ryood/Nucleo_DCO/chassis/Nucleo_DCO_Panel_Design.xlsx

Nucleo_DCO_Panel_Design
2018.11.27
 |  |  |  |  |  |  |  |  | Power LED
 | OSC1 Shape |  | OSC2 Shape |  | OSC3 Shape |  | Master Level
 | OSC1 Detune |  | OSC2 Detune |  | OSC3 Detune |  | Frequency
 | OSC1 Range |  | OSC2 Range |  | OSC3 Range
 |  | LED |  | LED |  | LED | Display | Displya
 | OSC1 PW Valid |  | OSC2 PW Valid |  | OSC3 PW Valid |  | Mode SW | Off SW
 |  |  |  |  |  |  | ADC Off | Reserved
 |  |  |  |  |  |  | SW | SW
 | OSC1 PW |  | OSC2 PW |  | OSC3 PW
 |  |  |  |  |  |  |  |  | LED
 |  |  |  |  |  |  |  |  | Level Clip
 | OSC1 Level |  | OSC2 Level |  | OSC3 Level |  | Digital Level
