ryood/Nucleo_DCO/chassis/Nucleo_DCO_Panel_Design.png

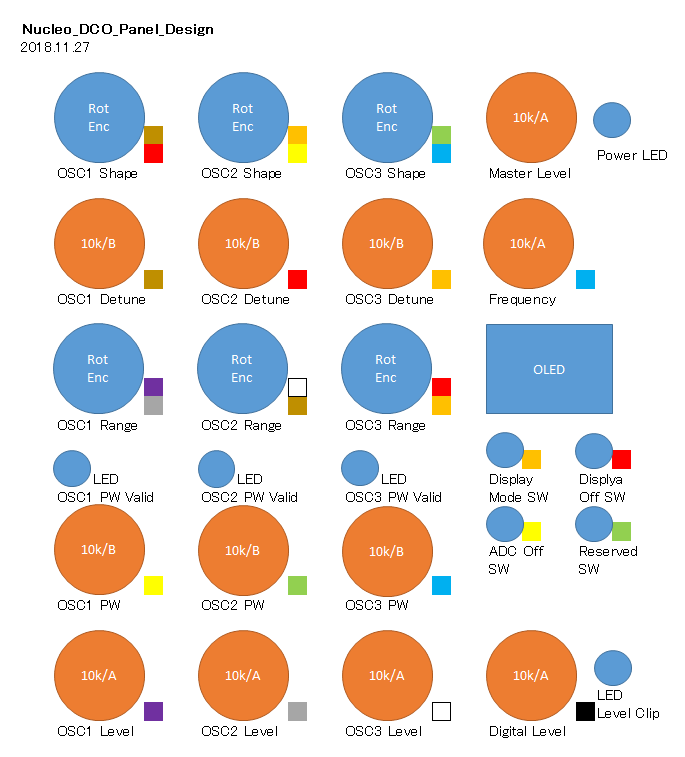
chassis/Nucleo_DCO_Panel_Design.png
