ryood/Nucleo_DCO/chassis/Test/Nucleo_DCO_Panel_Design.png

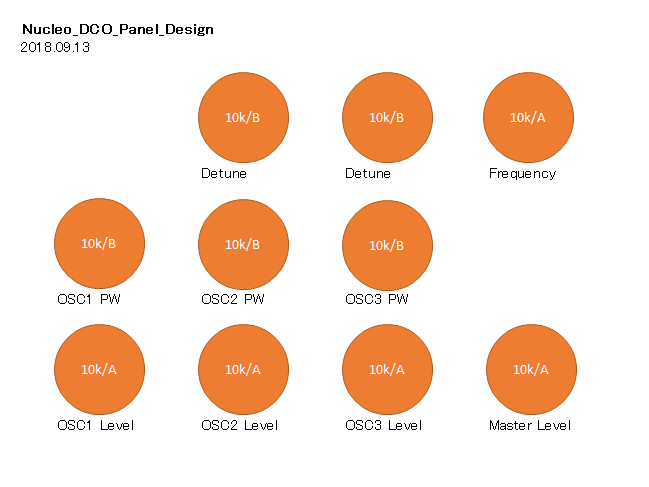
chassis/Test/Nucleo_DCO_Panel_Design.png
