ryood/Nucleo_DCO/fritzing/Nucleo_DCO_PSU_ブレッドボード.png

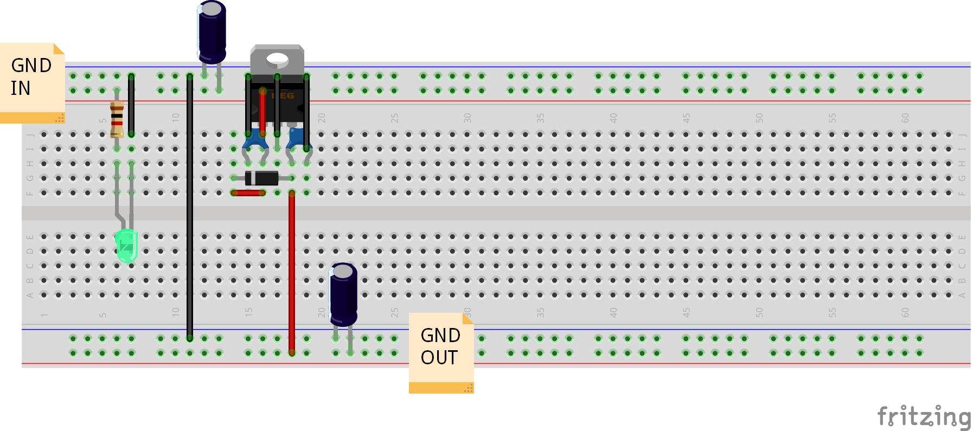
fritzing/Nucleo_DCO_PSU_ブレッドボード.png
