ryood/Nucleo_DCO/Nucleo_DCO ブロック図.png

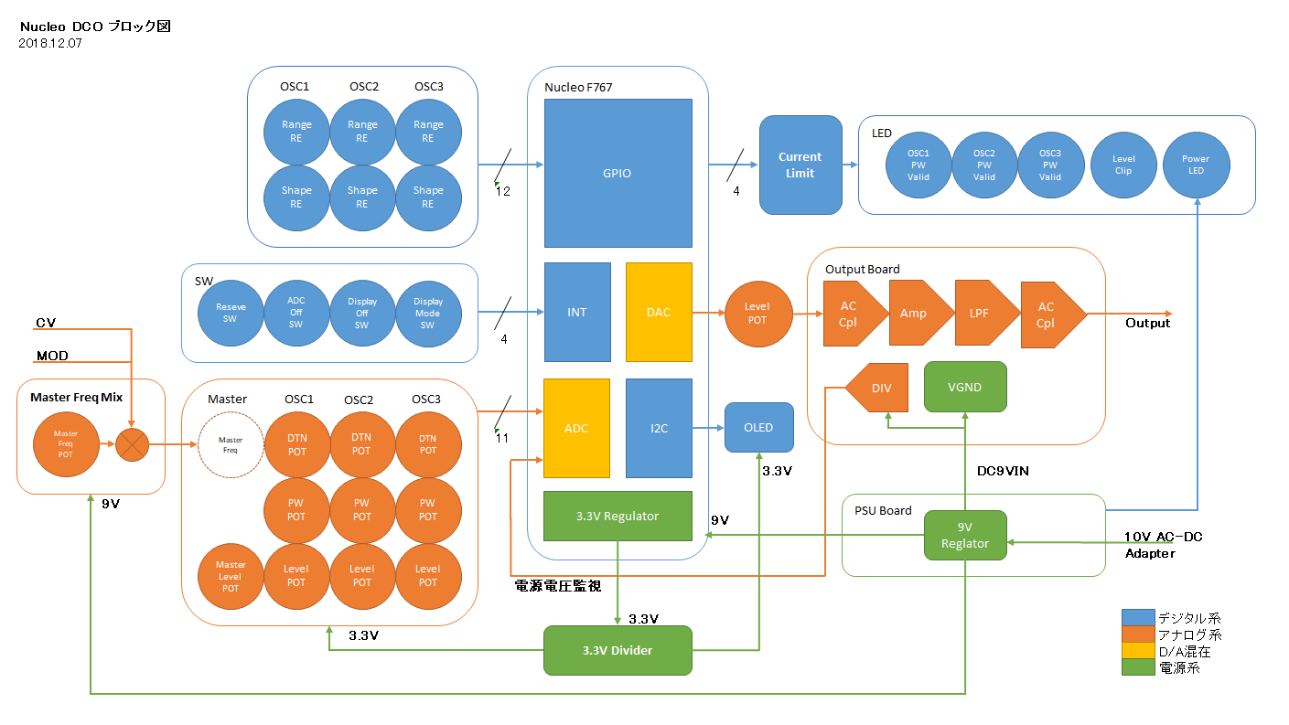
Nucleo_DCO ブロック図.png
