ryood/Nucleo_DCO/Nucleo_DCO ブロック図_Arduino_OLED.png

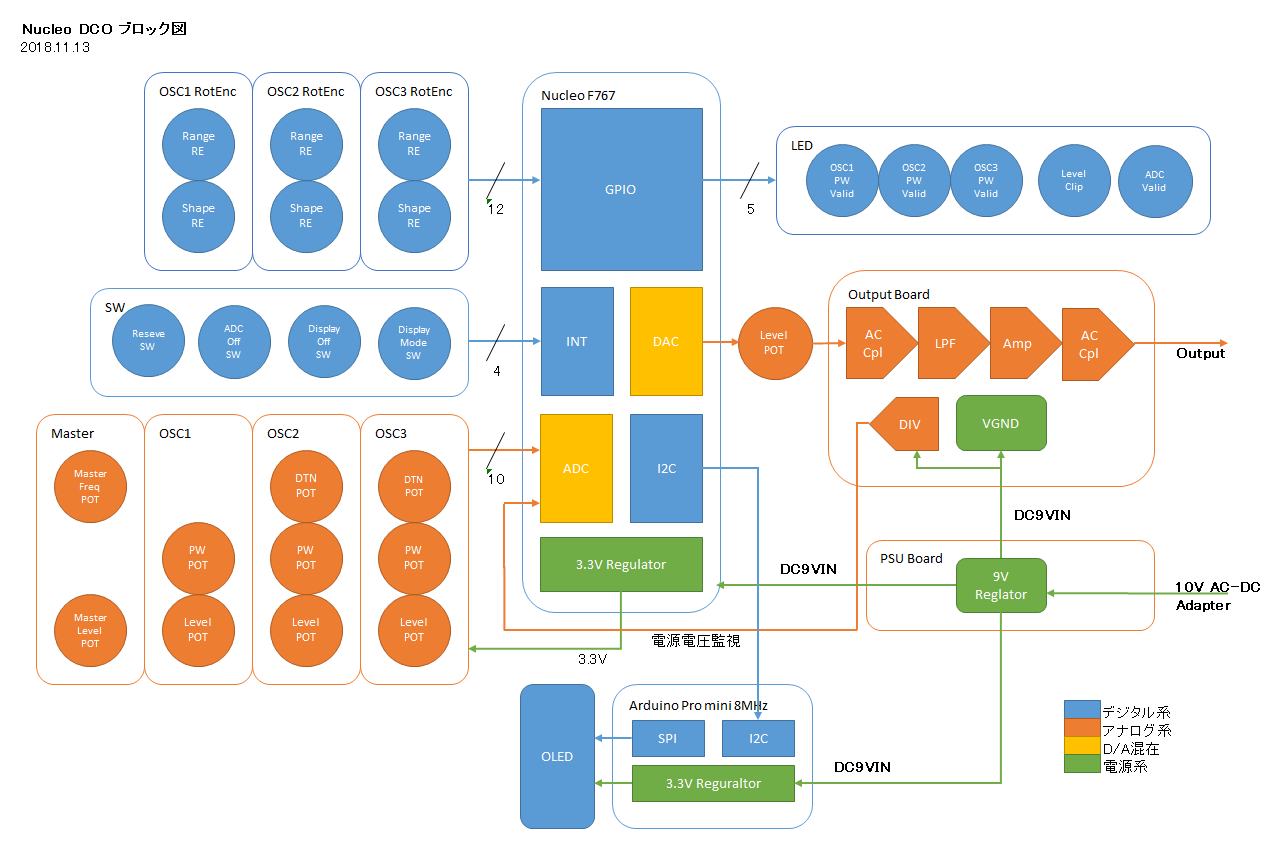
Nucleo_DCO ブロック図_Arduino_OLED.png
