ryood/Nucleo_DCO/Nucleo_DCO 出音テスト/Arduino EG テスト ブロック図.jpg

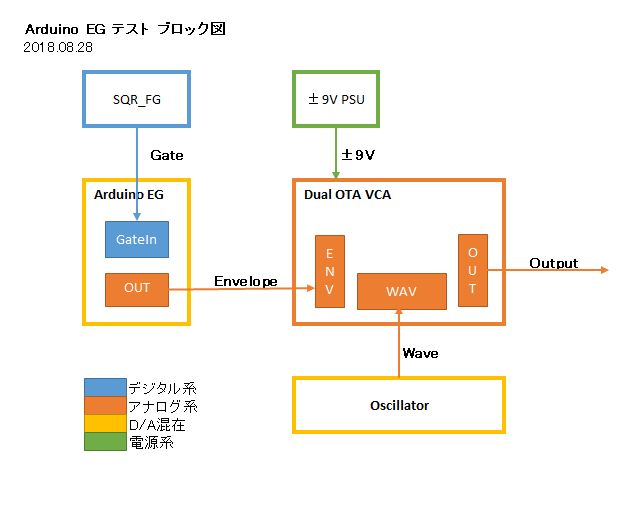
Nucleo_DCO 出音テスト/Arduino EG テスト ブロック図.jpg
