ryood/Nucleo_DCO/Nucleo_DCO 出音テスト/Nucleo_DCO + TLF 01(AntiLogMM) +Dual_OTA_VCA　＋Arduino_EG テストブロック図.png

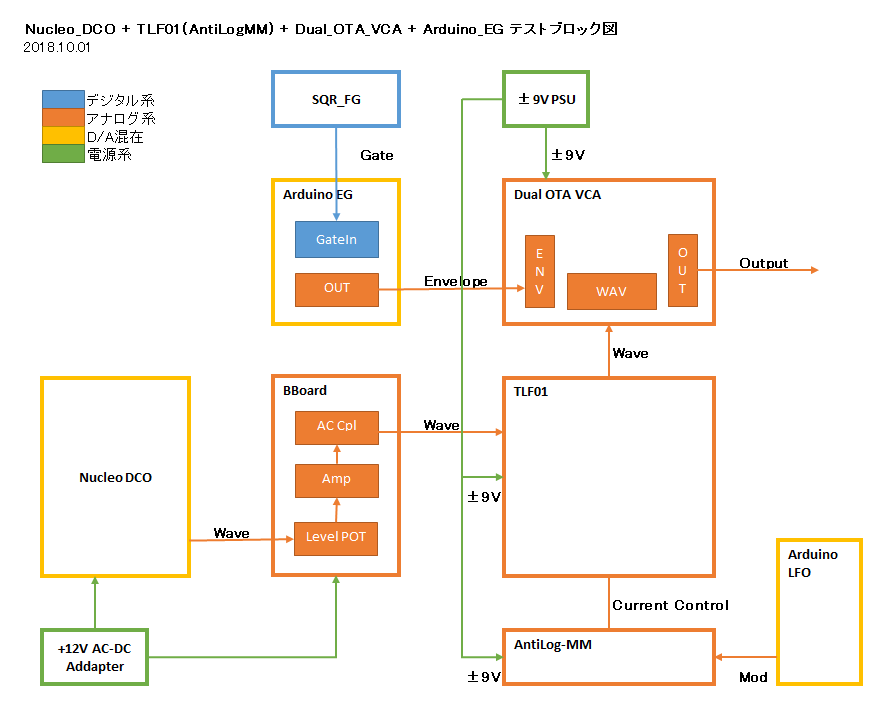
Nucleo_DCO 出音テスト/Nucleo_DCO + TLF 01(AntiLogMM) +Dual_OTA_VCA ＋Arduino_EG テストブロック図.png
