ryood/Nucleo_DCO/Nucleo_DCO 出音テスト/Nucleo_DCO ＋Dual_OTA_VCA + Arduino_LFO テスト ブロック図_V2.png

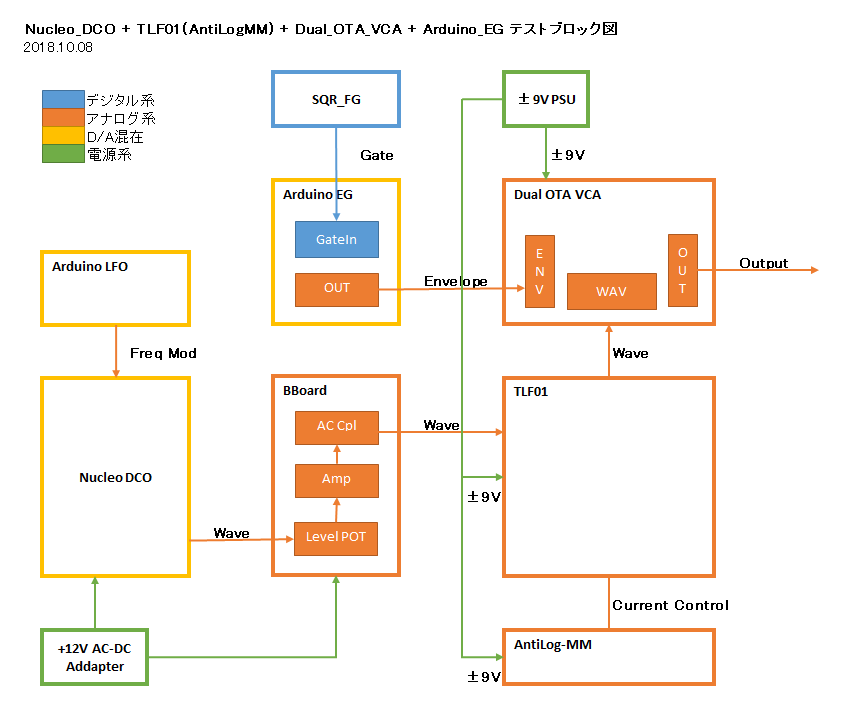
Nucleo_DCO 出音テスト/Nucleo_DCO ＋Dual_OTA_VCA + Arduino_LFO テスト ブロック図_V2.png
