ryood/Nucleo_DCO/Nucleo_DCO_Output_Board/eagle/Nucleo_DCO_Output_brd.png

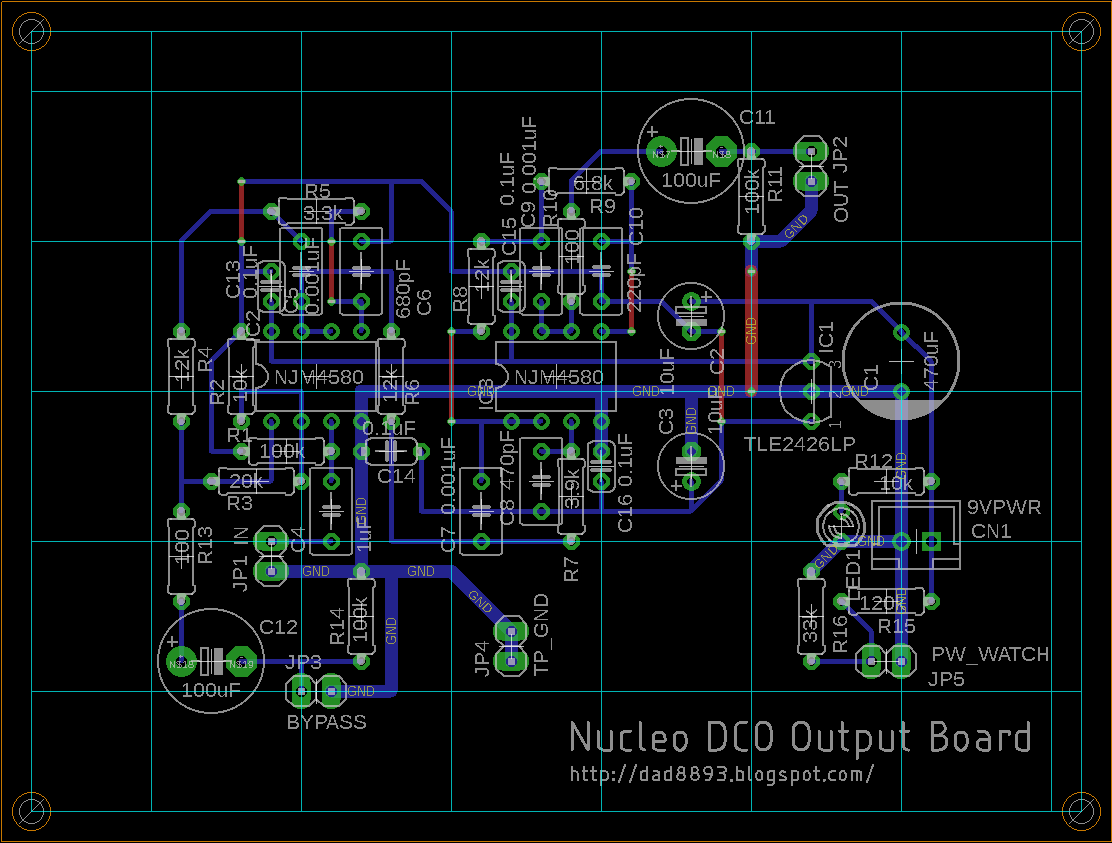
Nucleo_DCO_Output_Board/eagle/Nucleo_DCO_Output_brd.png
