ryood/Nucleo_DCO/Nucleo_DCO_Output_Board/eagle/Nucleo_DCO_Output_sch.png

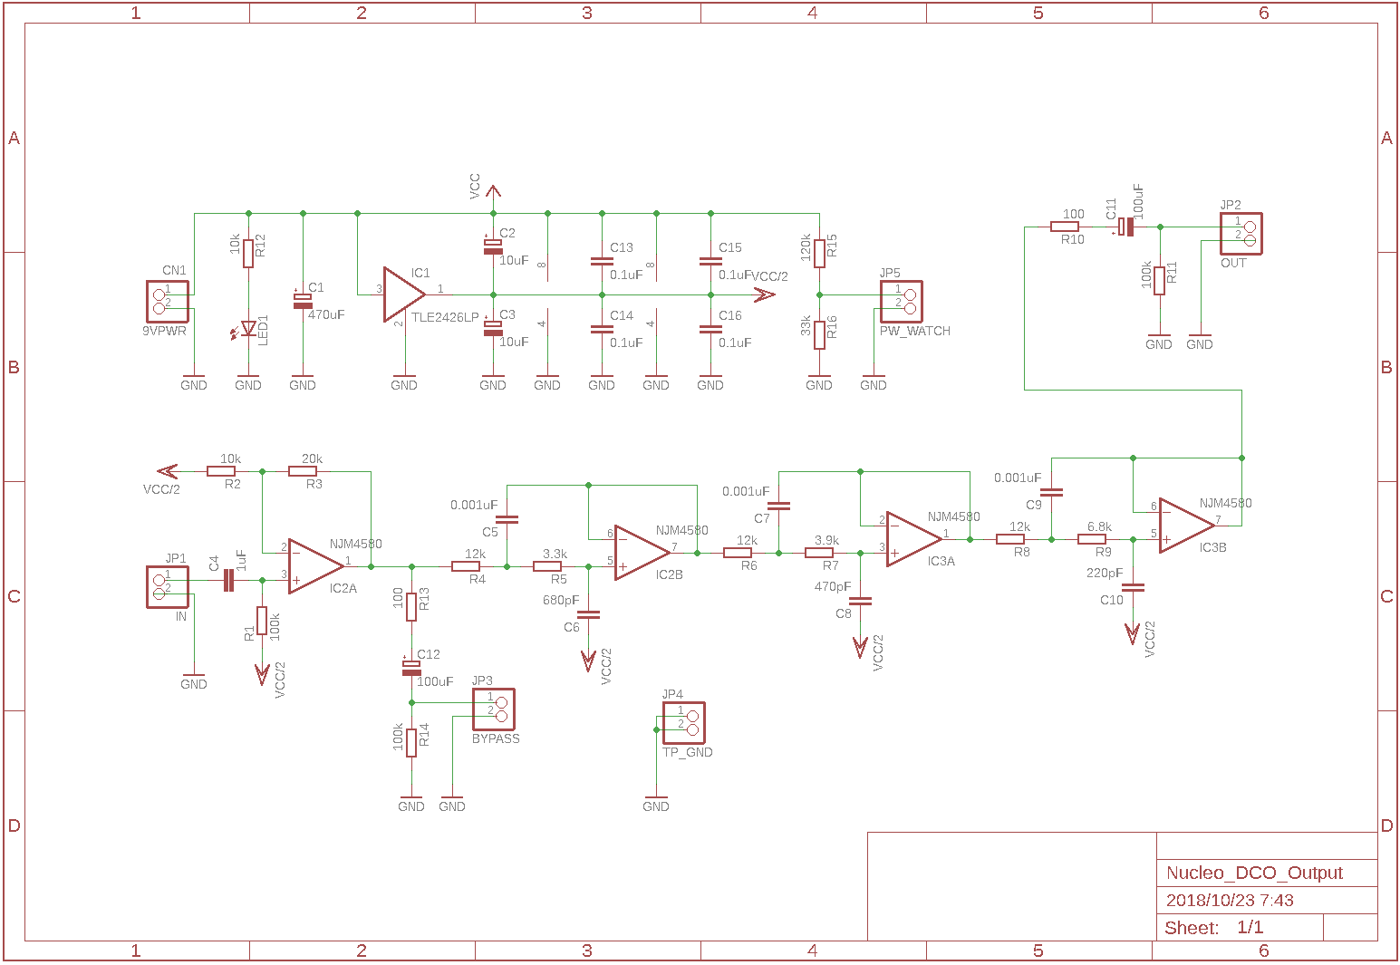
Nucleo_DCO_Output_Board/eagle/Nucleo_DCO_Output_sch.png
