ryood/Nucleo_DCO/Nucleo_DCO_Output_Board/fritzing/Nucleo_DCO_Output_VCVS_6th_Bessel _VGND+DCO_ブレッドボード.png

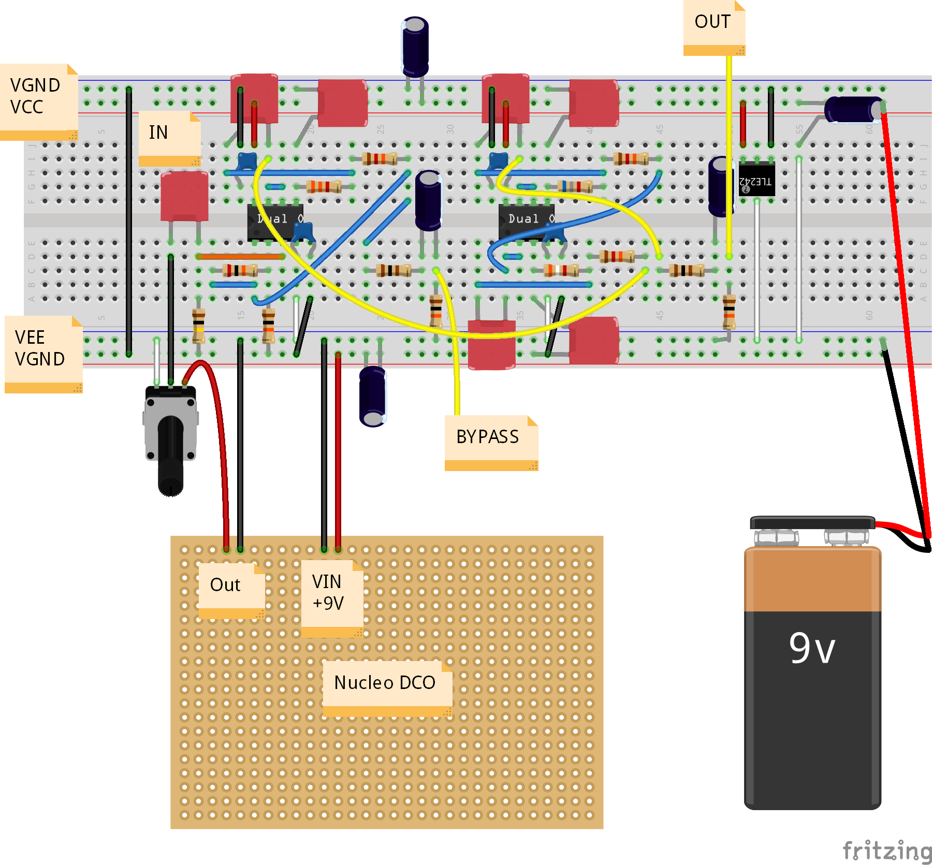
Nucleo_DCO_Output_Board/fritzing/Nucleo_DCO_Output_VCVS_6th_Bessel _VGND+DCO_ブレッドボード.png
