ryood/Nucleo_DCO/Nucleo_DCO_Output_Board/Nucleo_DCO_Output_Board_FChara.png

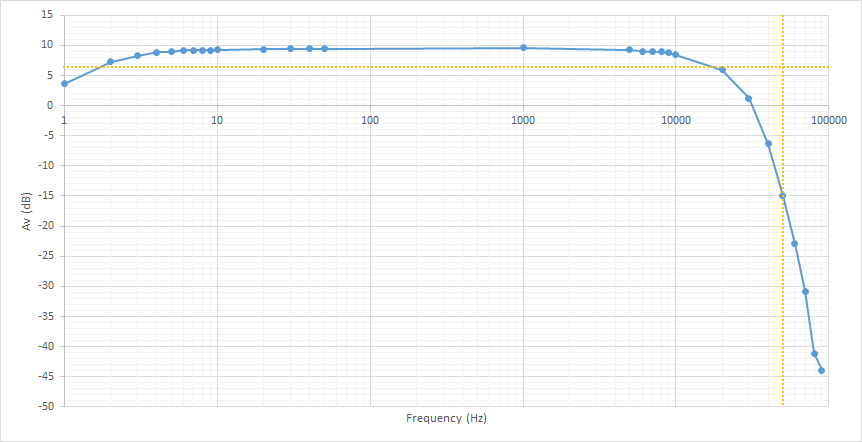
Nucleo_DCO_Output_Board/Nucleo_DCO_Output_Board_FChara.png
