ryood/Nucleo_DCO/Nucleo_DCO_Output_Board/Nucleo_DCO_出力部_ブロック図.png

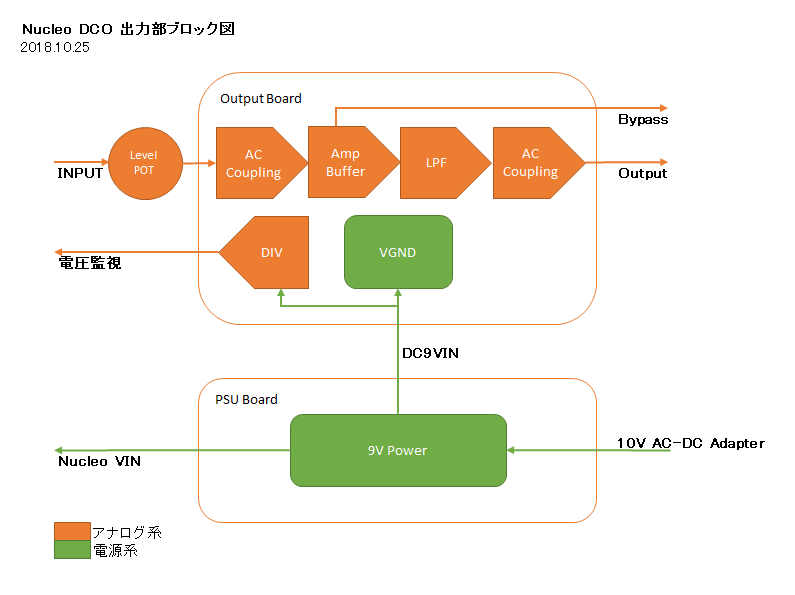
Nucleo_DCO_Output_Board/Nucleo_DCO_出力部_ブロック図.png
