ryood/Nucleo_DCO/Nucleo_DCO接続一覧表.png

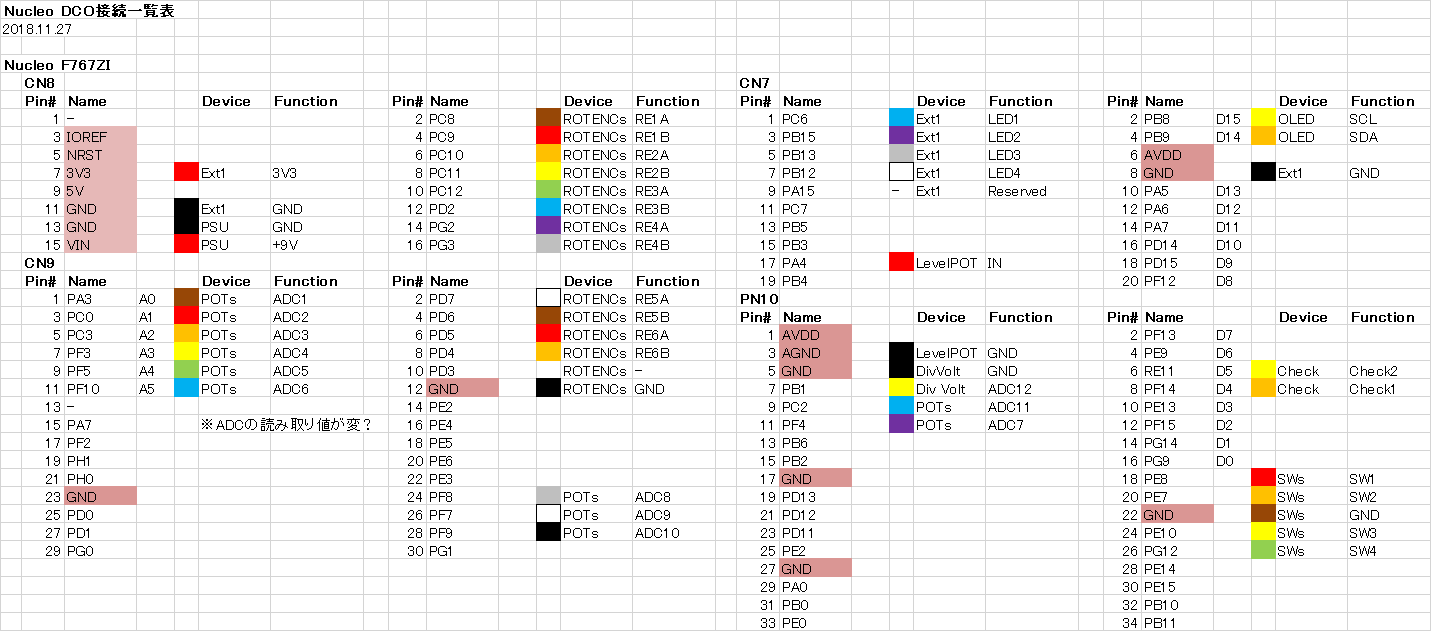
Nucleo_DCO接続一覧表.png
