ryood/Nucleo_DCO/mbed/Nucleo_DCO_Test04/Nucleo_DCO_Test04 ピンアサイン.xlsx

Nucleo_DCO_Test04 ピンアサイン
2018.08.30
Arduino | Nucleo | Description
D15 | PB_8 | OLED/I2C/SCL
D14 | PB_9 | OLED/I2C/SDA
GND | GND | OLED/GND
D5 | PE_11 | CheckPin
D4 | PF_14 | CheckPin
- | PA_4 | WaveOut
