ryood/Nucleo_DCO/Nucleo_DCO表示データ・I2C通信・フォーマット.xlsx

Nucleo_DCO表示データ・I2C通信・フォーマット
2018.11.03
I2C Clock(Hz) | 100000
Mode | Mode# | Name | 型 | Size(Byte) | 説明 | 通信バイト数 | 通信時間(us)
DM_TITLE | 0 | TitleStr1 | - | 0 | Mode#128以降の文字列を表示 | 0 | 160
DM_NORMAL | 1 | WaveShape1 | uint_8 | 1 | OSC1の波形番号
DM_NORMAL | 1 | WaveShape2 | uint_8 | 1 | OSC2の波形番号
DM_NORMAL | 1 | WaveShape3 | uint_8 | 1 | OSC3の波形番号
DM_NORMAL | 1 | FreqRange1 | uint_8 | 1 | OSC1の周波数レンジ番号
DM_NORMAL | 1 | FreqRange2 | uint_8 | 1 | OSC2の周波数レンジ番号
DM_NORMAL | 1 | FreqRange3 | uint_8 | 1 | OSC3の周波数レンジ番号
DM_NORMAL | 1 | FPS | uint_16 | 2 | フレームレート（0.1Hz単位）
DM_NORMAL | 1 | BattVoltage | uint_8 | 1 | 電源電圧（0.1V単位）
DM_NORMAL | 1 | ADCAvailable | uint_8 | 1 | ADC読み取り有効:1 無効:2 | 10 | 960
DM_FREQUENCY | 2 | Rate1 | uint_16 | 2 | OSC1の周波数(0.1Hz単位)
DM_FREQUENCY | 2 | Rate2 | uint_16 | 2 | OSC2の周波数(0.1Hz単位)
DM_FREQUENCY | 2 | Rate3 | uint_16 | 2 | OSC3の周波数(0.1Hz単位)
DM_FREQUENCY | 2 | Detune1 | int_16 | 2 | OSC1のデチューン(0.001Hz単位)
DM_FREQUENCY | 2 | Detune2 | int_16 | 2 | OSC2のデチューン(0.001Hz単位)
DM_FREQUENCY | 2 | Detune3 | int_16 | 2 | OSC3のデチューン(0.001Hz単位) | 12 | 1120
DM_AMPLITUDE | 3 | Amplitude1 | int16 | 2 | OSC1のボリューム(0.001単位）
DM_AMPLITUDE | 3 | Amplitude2 | int16 | 2 | OSC2のボリューム(0.001単位）
DM_AMPLITUDE | 3 | Amplitude3 | int16 | 2 | OSC3のボリューム(0.001単位）
DM_AMPLITUDE | 3 | MasterAmplitude | int16 | 2 | マスターボリューム(0.001単位）
DM_AMPLITUDE | 3 | Clip | uint8_t | 1 | クリップ 有:1 無:0 | 9 | 880
DM_PULSE_WIDTH | 4 | PulseWidth1 | int16 | 2 | OSC1のパルスワイズ(0.001単位)
DM_PULSE_WIDTH | 4 | PulseWidth2 | int16 | 2 | OSC1のパルスワイズ(0.001単位)
DM_PULSE_WIDTH | 4 | PulseWidth3 | int16 | 2 | OSC1のパルスワイズ(0.001単位) | 6 | 640
TITLE_STR1 | 128 | TitleStr1 | 固定長文字列 | 32 | プログラム名
TITLE_STR2 | 129 | TitleStr2 | 固定長文字列 | 32 | 日付
TITLE_STR3 | 130 | TitleStr3 | 固定長文字列 | 32 | 時刻 | 96 | 7840
DM_DISPLAY_OFF | 255 | DisplayMessage | uint8_t | 1 | メッセージの表示:1 非表示:0 | 1 | 240
