ryood/Nucleo_DCO/Nucleo_DCO_Output_Board/Nucleo DCO LPF 設計.xlsx

Nucleo DCO LPF 設計
2018.10.04
MFB 4次バターワース特性
fc | 25000 | Hz
ステージ | F0 | fc | Q
1st | 1 | 25000 | 0.5412
2nd | 1 | 25000 | 1.3065
1st |  |  |  | ステージ | R1(kΩ) | R2(kΩ) | R3(kΩ) | C1(uF) | C2(pF)
R1 | 3.9 | kΩ |  | 1st | 3.9 | 10 | 3.9 | 0.0022 | 470
R2 | 10 | kΩ |  | 2nd | 4.7 | 8.2 | 4.7 | 0.0047 | 220
R3 | 3.9 | kΩ
C1 | 0.0022 | uF
C2 | 470 | pF
2nd
R1 | 4.7 | kΩ
R2 | 8.2 | kΩ
R3 | 4.7 | kΩ
C1 | 0.0047 | uF
C2 | 220 | pF
MFB 4次ベッセル特性
fc | 25000 | Hz
ステージ | F0 | fc | Q
1st | 1.4192 | 35480 | 0.5219
2nd | 1.5912 | 39780 | 0.8055
1st |  |  |  | ステージ | R1(kΩ) | R2(kΩ) | R3(kΩ) | C1(uF) | C2(pF)
R1 | 3.9 | kΩ |  | 1st | 3.9 | 12 | 3.9 | 0.0015 | 330
R2 | 12 | kΩ |  | 2nd | 3.3 | 8.2 | 3.3 | 0.0022 | 220
R3 | 3.9 | kΩ
C1 | 0.0015 | uF
C2 | 330 | pF
2nd
R1 | 3.3 | kΩ
R2 | 8.2 | kΩ
R3 | 3.3 | kΩ
C1 | 0.0022 | uF
C2 | 220 | pF
MFB 4次ベッセル特性
fc | 20000 | Hz
ステージ | F0 | fc | Q
1st | 1.4192 | 28384 | 0.5219
2nd | 1.5912 | 31824 | 0.8055
1st |  |  |  | ステージ | R1(kΩ) | R2(kΩ) | R3(kΩ) | C1(uF) | C2(pF)
R1 | 4.7 | kΩ |  | 1st | 4.7 | 8.2 | 4.7 | 0.0015 | 470
R2 | 8.2 | kΩ |  | 2nd | 4.7 | 12 | 4.7 | 0.0022 | 220
R3 | 4.7 | kΩ
C1 | 0.0015 | uF
C2 | 470 | pF
2nd
R1 | 4.7 | kΩ
R2 | 12 | kΩ
R3 | 4.7 | kΩ
C1 | 0.0022 | uF
C2 | 220 | pF
MFB 8次ベッセル特性
fc | 25000 | Hz
ステージ | F0 | fc | Q
1st | 1.7838 | 44595 | 0.506
2nd | 2.1953 | 54882.5 | 1.2258
3rd | 1.9591 | 48977.5 | 0.7109
4th | 1.8378 | 45945 | 0.5597
1st |  |  |  | ステージ | R1(kΩ) | R2(kΩ) | R3(kΩ) | C1(uF) | C2(pF)
R1 | 3.9 | kΩ |  | 1st | 3.9 | 15 | 3.9 | 0.001 | 220
R2 | 15 | kΩ |  | 2nd | 3.9 | 15 | 3.9 | 0.0022 | 68
R3 | 3.9 | kΩ |  | 3rd | 3.3 | 15 | 3.3 | 0.0015 | 150
C1 | 0.001 | uF |  | 4th | 4.7 | 12 | 4.7 | 0.001 | 220
C2 | 220 | pF
2nd
R1 | 3.9 | kΩ
R2 | 15 | kΩ
R3 | 3.9 | kΩ
C1 | 0.0022 | uF
C2 | 68 | pF
3rd
R1 | 3.3 | kΩ
R2 | 15 | kΩ
R3 | 3.3 | kΩ
C1 | 0.0015 | uF
C2 | 150 | pF
4th
R1 | 4.7 | kΩ
R2 | 12 | kΩ
R3 | 4.7 | kΩ
C1 | 0.001 | uF
C2 | 220 | pF
MFB 8次ベッセル特性
fc | 20000 | Hz
ステージ | F0 | fc | Q
1st | 1.7838 | 35676 | 0.506
2nd | 2.1953 | 43906 | 1.2258
3rd | 1.9591 | 39182 | 0.7109
4th | 1.8378 | 36756 | 0.5597
1st |  |  |  | ステージ | R1(kΩ) | R2(kΩ) | R3(kΩ) | C1(uF) | C2(pF)
R1 | 3.3 | kΩ |  | 1st | 3.3 | 12 | 3.3 | 0.0015 | 330
R2 | 12 | kΩ |  | 2nd | 4.7 | 12 | 4.7 | 0.0022 | 100
R3 | 3.3 | kΩ |  | 3rd | 4.7 | 10 | 4.7 | 0.0015 | 220
C1 | 0.0015 | uF |  | 4th | 3.9 | 8.2 | 3.9 | 0.0015 | 330
C2 | 330 | pF
2nd
R1 | 4.7 | kΩ
R2 | 12 | kΩ
R3 | 4.7 | kΩ
C1 | 0.0022 | uF
C2 | 100 | pF
3rd
R1 | 4.7 | kΩ
R2 | 10 | kΩ
R3 | 4.7 | kΩ
C1 | 0.0015 | uF
C2 | 220 | pF
4th
R1 | 3.9 | kΩ
R2 | 8.2 | kΩ
R3 | 3.9 | kΩ
C1 | 0.0015 | uF
C2 | 330 | pF
MFB 6次ベッセル特性
fc | 20000 | Hz
ステージ | F0 | fc | Q
1st | 1.606 | 32120 | 0.5103
2nd | 1.6913 | 33826 | 0.6112
3rd | 1.9071 | 38142 | 1.0234
1st |  |  |  | ステージ | R1(kΩ) | R2(kΩ) | R3(kΩ) | C1(uF) | C2(pF)
R1 | 3.9 | kΩ |  | 1st | 3.9 | 1.2 | 3.9 | 0.0015 | 330
R2 | 12 | kΩ |  | 2nd | 4.7 | 8.2 | 4.7 | 0.0015 | 330
R3 | 3.9 | kΩ |  | 3rd | 4.7 | 12 | 4.7 | 0.0022 | 150
C1 | 0.0015 | uF
C2 | 330 | pF
2nd
R1 | 4.7 | kΩ
R2 | 8.2 | kΩ
R3 | 4.7 | kΩ
C1 | 0.0015 | uF
C2 | 330 | pF
3rd
R1 | 4.7 | kΩ
R2 | 12 | kΩ
R3 | 4.7 | kΩ
C1 | 0.0022 | uF
C2 | 150 | pF
VCVS 6次ベッセル特性
fc | 20000 | Hz
ステージ | F0 | fc | Q
1st | 1.606 | 32120 | 0.5103
2nd | 1.6913 | 33826 | 0.6112
3rd | 1.9071 | 38142 | 1.0234
1st |  |  |  | ステージ | R1(kΩ) | R2(kΩ) | C1(uF) | C2(pF)
R1 | 12 | kΩ |  | 1st | 12 | 3.3 | 0.001 | 680
R2 | 3.3 | kΩ |  | 2nd | 12 | 3.9 | 0.001 | 470
C1 | 0.001 | uF |  | 3rd | 12 | 6.8 | 0.001 | 220
C2 | 680 | pF
2nd
R1 | 12 | kΩ
R2 | 3.9 | kΩ
C1 | 0.001 | uF
C2 | 470 | pF
3rd
R1 | 12 | kΩ
R2 | 6.8 | kΩ
C1 | 0.001 | uF
C2 | 220 | pF
