ryood/Nucleo_DCO/(list of files, cad)

Other CAD files:
chassis/Nucleo_DCO_Top_Panel.dwg
chassis/Test/NucleoDCO_RotEnc_Panel(Test).dwg
chassis/Nucleo_DCO_Bottom_Panel.dwg
chassis/Test/NucleoDCO_POT_Panel(Test).dwg
