ryood/Nucleo_DCO/doc/Floating Point Test Result 20180915.txt

===============================
Mbed OS 5

Floating Point Test
Sep 15 2018 20:30:57

LOOP_N: 100000

float
op      total   1-op(us)
-------------------------------
addf    3708    0.037080
subf    7417    0.074170
mulf    11125   0.111250
divf    21784   0.217840
sinf    55664   0.556640
cosf    59404   0.594040
expf    76539   0.765390
logf    82766   0.827660
sqrtf   131143  1.311430
powf32  228002  2.280020
tword_f 218120  2.181200

double
op      total   1-op(us)
-------------------------------
add     223522  2.235220
sub     229228  2.292280
mul     236179  2.361790
div     254717  2.547170
sin     88683   0.886830
cos     95088   0.950880
exp     116889  1.168890
log     127590  1.275900
sqrt    323866  3.238660
pow32   60690   0.606900
tword   21782   0.217820

End.

===============================
Mbed 2

Floating Point Test
Sep 15 2018 11:33:49

LOOP_N: 100000

float
op      total   1-op(us)
-------------------------------
addf    2549    0.025490
subf    4866    0.048660
mulf    7416    0.074160
divf    16682   0.166820
sinf    37082   0.370820
cosf    35549   0.355490
expf    53734   0.537340
logf    48837   0.488370
sqrtf   22935   0.229350
powf32  159155  1.591550
tword_f 160074  1.600740

double
op      total   1-op(us)
-------------------------------
add     164085  1.640850
sub     168400  1.684000
mul     173960  1.739600
div     190871  1.908710
sin     93309   0.933090
cos     111853  1.118530
exp     104258  1.042580
log     136975  1.369750
sqrt    37065   0.370650
pow32   392082  3.920820
tword   348061  3.480610

End.
