ryood/Nucleo_DCO/doc/InterpolateFloat Result.txt

0.172,  0.456,  0.176,  0.457,  0.512,  0.174,  0.515,  0.467,  0.165,  0.164,
0.172,  0.456,  0.176,  0.457,  0.512,  0.174,  0.516,  0.466,  0.165,  0.164,
0.172,  0.456,  0.176,  0.457,  0.512,  0.174,  0.515,  0.466,  0.165,  0.163,
0.172,  0.457,  0.176,  0.457,  0.512,  0.173,  0.516,  0.466,  0.165,  0.163,
0.172,  0.456,  0.176,  0.457,  0.512,  0.172,  0.515,  0.466,  0.165,  0.163,
0.173,  0.456,  0.176,  0.457,  0.512,  0.173,  0.515,  0.466,  0.165,  0.163,
0.173,  0.456,  0.176,  0.457,  0.512,  0.173,  0.516,  0.466,  0.165,  0.164,
0.173,  0.456,  0.176,  0.457,  0.512,  0.173,  0.516,  0.466,  0.165,  0.164,
0.172,  0.456,  0.176,  0.457,  0.512,  0.173,  0.515,  0.466,  0.165,  0.164,
0.173,  0.456,  0.176,  0.457,  0.512,  0.173,  0.515,  0.467,  0.165,  0.164,
0.173,  0.456,  0.176,  0.457,  0.512,  0.174,  0.515,  0.466,  0.165,  0.163,
0.173,  0.456,  0.176,  0.457,  0.512,  0.173,  0.515,  0.467,  0.165,  0.164,
0.173,  0.456,  0.176,  0.457,  0.512,  0.173,  0.515,  0.467,  0.165,  0.164,
0.173,  0.456,  0.176,  0.457,  0.512,  0.172,  0.515,  0.467,  0.165,  0.164,
0.173,  0.456,  0.176,  0.457,  0.512,  0.172,  0.516,  0.467,  0.165,  0.164,
0.173,  0.456,  0.176,  0.457,  0.512,  0.171,  0.515,  0.467,  0.165,  0.164,
0.172,  0.456,  0.176,  0.457,  0.512,  0.172,  0.516,  0.467,  0.165,  0.163,
0.172,  0.456,  0.176,  0.457,  0.512,  0.172,  0.515,  0.467,  0.165,  0.163,
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
0.171,  0.452,  0.175,  0.453,  0.507,  0.172,  0.510,  0.463,  0.163,  0.162,
0.171,  0.452,  0.175,  0.453,  0.508,  0.173,  0.510,  0.463,  0.164,  0.162,
0.171,  0.453,  0.175,  0.453,  0.508,  0.173,  0.511,  0.464,  0.164,  0.162,
0.171,  0.453,  0.176,  0.454,  0.509,  0.173,  0.513,  0.464,  0.164,  0.163,
0.172,  0.454,  0.175,  0.454,  0.510,  0.173,  0.514,  0.465,  0.164,  0.163,
0.172,  0.454,  0.176,  0.454,  0.510,  0.172,  0.513,  0.465,  0.164,  0.163,
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
