ryood/Nucleo_DCO/fritzing/ADC_VREF_Test01_ブレッドボード.png

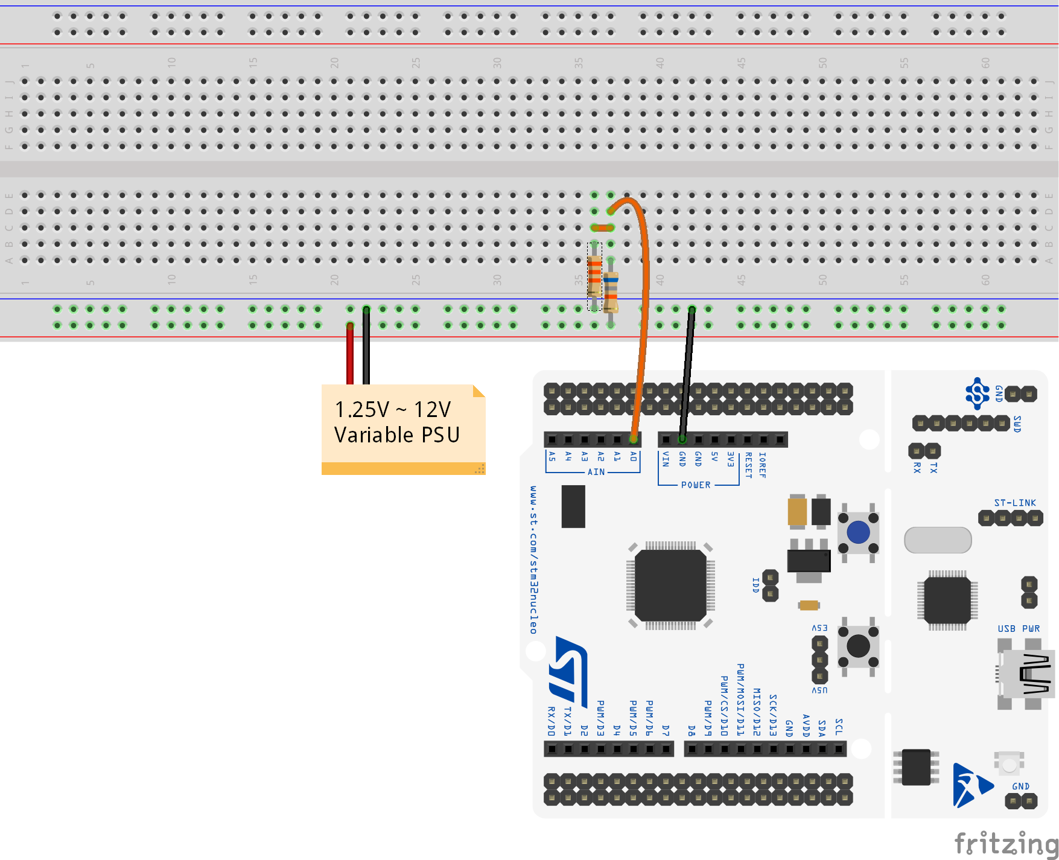
fritzing/ADC_VREF_Test01_ブレッドボード.png
