ryood/Nucleo_DCO/fritzing/Nucleo_DCO_Test20_Single_Supply_OutputBoard_ブレッドボード.png

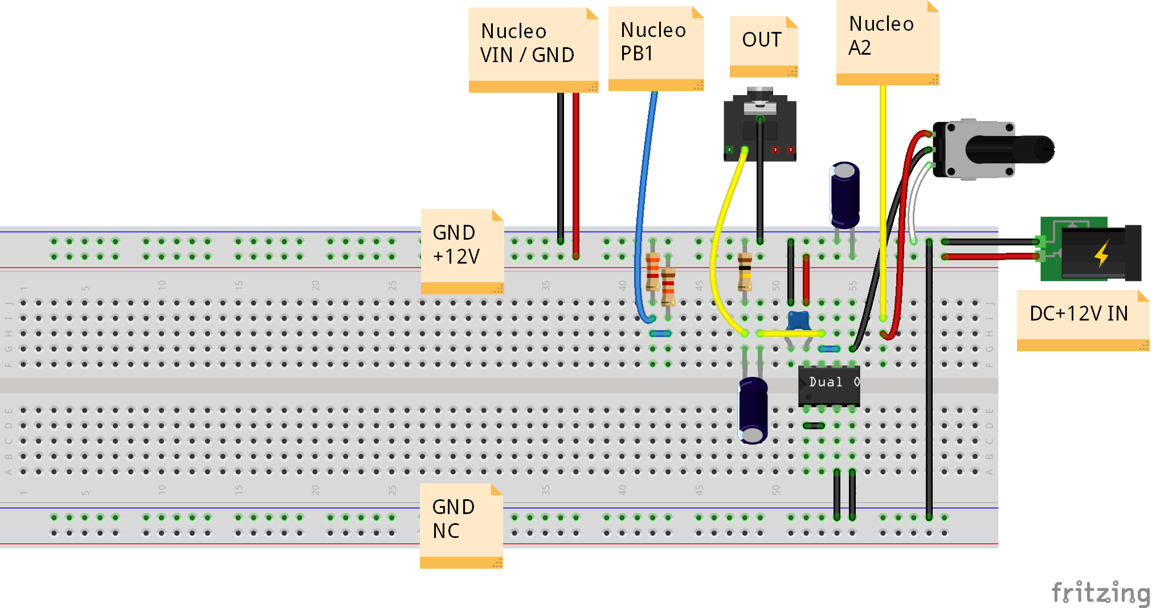
fritzing/Nucleo_DCO_Test20_Single_Supply_OutputBoard_ブレッドボード.png
