ryood/Nucleo_DCO/spice/Nucleo_DCO_Mix.asc

R1: res; 1k
R2: res; 1k
U1: UniversalOpamp2
V1: voltage; SINE(0.5 0.5 1k)
V2: voltage; SINE(0.5 0.5 2k 0 0 {Phase})
V3: voltage; 9
Named nets: 0, VCC, OUT
.tran 3m
.step param phase list 0 180
