ryood/Nucleo_DCO/Nucleo_DCO_Output_Board/spice/Nucleo_DCO_Output_VCVS_6th_Bessel_SQR_2.asc

C1: cap; 0.001u
C2: cap; 680p
C3: cap; 0.001u
C4: cap; 470p
C5: cap; 0.001u
C6: cap; 220p
C7: cap; 1u
C8: cap; 100u
C9: cap; 100u
R1: res; 12k
R2: res; 3.3k
R3: res; 12k
R4: res; 3.9k
R5: res; 12k
R6: res; 6.8k
R7: res; 10k
R8: res; 20k
R9: res; 2.5k
R10: res; 7.5k
R11: res; 100k
R12: res; 10k
R13: res; 10k
R14: res; 100
R15: res; 100
U1: UniversalOpamp2
U2: UniversalOpamp2
U3: UniversalOpamp2
U4: UniversalOpamp2
V1: voltage; PULSE(0 3 0 1f 1f 25u 50u); AC 1
V2: voltage; 4.5
V3: voltage; 4.5
Named nets: VCC, IN, OUT, 0, BYPASS, VEE, VCC/2, V1
.tran 0 1 999.85m
;ac oct 40 1 100k
10k/A POT
