ryood/Nucleo_DCO/Nucleo_DCO_Output_Board/spice/Nucleo_DCO_LFO_MFB_4th.asc

C1: cap; ""
C2: cap; ""
C3: cap; ""
C4: cap; ""
R1: res; ""
R2: res; ""
R3: res; ""
R4: res; ""
R5: res; ""
R6: res; ""
U1: UniversalOpamp2
U2: UniversalOpamp2
V1: voltage; ""; AC 1
V2: voltage; 4.5
V3: voltage; -4.5
Named nets: 0, VCC, VEE, OUT, IN
.tran 0 100m 97m
;ac oct 20 1k 100k
