ryood/Nucleo_DCO/Nucleo_DCO_Output_Board/spice/Nucleo_DCO_LFO_MFB_4th_BW_25kHzz@10kHzSaw.asc

C1: cap; 0.0022u
C2: cap; 470p
C3: cap; 0.0047u
C4: cap; 220p
R1: res; 3.9k
R2: res; 10k
R3: res; 3.9k
R4: res; 4.7k
R5: res; 8.2k
R6: res; 4.7k
U1: UniversalOpamp2
U2: UniversalOpamp2
V1: voltage; PULSE(-1 1 0 0.1m 0 0 0.1m); AC 1
V2: voltage; 4.5
V3: voltage; -4.5
Named nets: 0, VCC, VEE, OUT, IN
;tran 0 10m 9.7m
.ac oct 40 1k 100k
