ryood/Nucleo_DCO/Nucleo_DCO_Output_Board/spice/Nucleo_DCO_LFO_MFB_8th.asc

C1: cap; ""
C2: cap; ""
C3: cap; ""
C4: cap; ""
C5: cap; ""
C6: cap; ""
C7: cap; ""
C8: cap; ""
R1: res; ""
R2: res; ""
R3: res; ""
R4: res; ""
R5: res; 15k
R6: res; ""
R7: res; ""
R8: res; ""
R9: res; ""
R10: res; ""
R11: res; ""
R12: res; ""
U1: UniversalOpamp2
U2: UniversalOpamp2
U3: UniversalOpamp2
U4: UniversalOpamp2
V1: voltage; ""; AC 1
V2: voltage; 4.5
V3: voltage; -4.5
Named nets: 0, VCC, VEE, IN, OUT
;tran 0 10m 9.7m
.ac oct 40 1k 100k
