ryood/Nucleo_DCO/Nucleo_DCO_Output_Board/spice/Nucleo_DCO_LFO_MFB_8th_Bessel_20kHz@10kHzSaw.asc

C1: cap; 0.0015u
C2: cap; 330p
C3: cap; 0.0022u
C4: cap; 100p
C5: cap; 0.0015u
C6: cap; 220p
C7: cap; 0.0015u
C8: cap; 330p
R1: res; 3.3k
R2: res; 12k
R3: res; 3.3k
R4: res; 4.7k
R5: res; 12k
R6: res; 4.7k
R7: res; 4.7k
R8: res; 10k
R9: res; 4.7k
R10: res; 3.9k
R11: res; 8.2k
R12: res; 3.9k
U1: UniversalOpamp2
U2: UniversalOpamp2
U3: UniversalOpamp2
U4: UniversalOpamp2
V1: voltage; PULSE(-1 1 0 0.1m 0 0 0.1m); AC 1
V2: voltage; 4.5
V3: voltage; -4.5
Named nets: 0, VCC, VEE, IN, OUT
;tran 0 10m 9.7m
.ac oct 40 1k 100k
