ryood/Nucleo_DCO/Nucleo_DCO_Output_Board/spice/Nucleo_DCO_LFO_MFB_8th_Bessel_25kHz@1kHzSaw.asc

C1: cap; 0.001u
C2: cap; 220p
C3: cap; 0.0022u
C4: cap; 68p
C5: cap; 0.0015u
C6: cap; 150p
C7: cap; 0.001u
C8: cap; 220p
R1: res; 3.9k
R2: res; 15k
R3: res; 3.9k
R4: res; 3.9k
R5: res; 15k
R6: res; 3.9k
R7: res; 3.3k
R8: res; 15k
R9: res; 3.3k
R10: res; 4.7k
R11: res; 12k
R12: res; 4.7k
U1: UniversalOpamp2
U2: UniversalOpamp2
U3: UniversalOpamp2
U4: UniversalOpamp2
V1: voltage; PULSE(-1 1 0 1m 0 0 1m); AC 1
V2: voltage; 4.5
V3: voltage; -4.5
Named nets: 0, VCC, VEE, IN, OUT
.tran 0 100m 97m
;ac oct 20 1k 100k
