ryood/Nucleo_DCO/(list of files, drawings)

Other design files:
fritzing/ADC_VREF_Test01.fzz
fritzing/GateGen01.fzz
fritzing/Nucleo_DCO_PSU.fzz
fritzing/Nucleo_DCO_Test20_Single_Supply_OutputBoard.fzz
Nucleo_DCO_Output_Board/fritzing/Nucleo_DCO_Output_VCVS_6th_Bessel _VGND+DCO.fzz
Nucleo_DCO_Output_Board/fritzing/Nucleo_DCO_Output_VCVS_6th_Bessel _VGND.fzz
Nucleo_DCO_Output_Board/fritzing/Nucleo_DCO_Output_VCVS_6th_Bessel.fzz
