ryood/Nucleo_DCO/Nucleo_DCO_EX1_Board/eagle/Nucleo_DCO_EX1/Nucleo_DCO_EX1.brd

## EAGLE design Nucleo_DCO_EX1_Board/eagle/Nucleo_DCO_EX1/Nucleo_DCO_EX1.brd (2018-11-26)

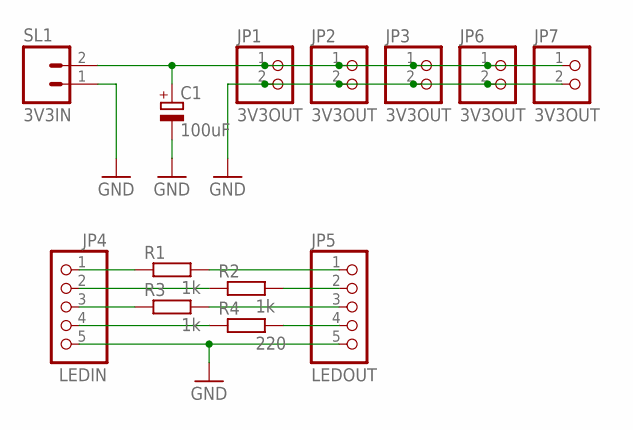
[picture p21: schematic Nucleo_DCO_EX1.sch]

Parts:
C1: 100uF; SANYO-OSCON_C6
JP1, JP2, JP3, JP6, JP7: 3V3OUT; 1X02
JP4: LEDIN; 1X05
JP5: LEDOUT; 1X05
R1, R2, R3: 1k; 0207/7
R4: 220; 0207/7
SL1: 3V3IN; 02P

Connections:
GND: C1.-, JP1.2, JP2.2, JP3.2, JP4.5, JP5.5, JP6.2, JP7.2, SL1.1
unnamed: C1.+, JP1.1, JP2.1, JP3.1, JP6.1, JP7.1, SL1.2
unnamed: JP4.1, R1.1
unnamed: JP5.1, R1.2
unnamed: JP4.2, R2.1
unnamed: JP5.2, R2.2
unnamed: JP4.3, R3.1
unnamed: JP5.3, R3.2
unnamed: JP4.4, R4.1
unnamed: JP5.4, R4.2

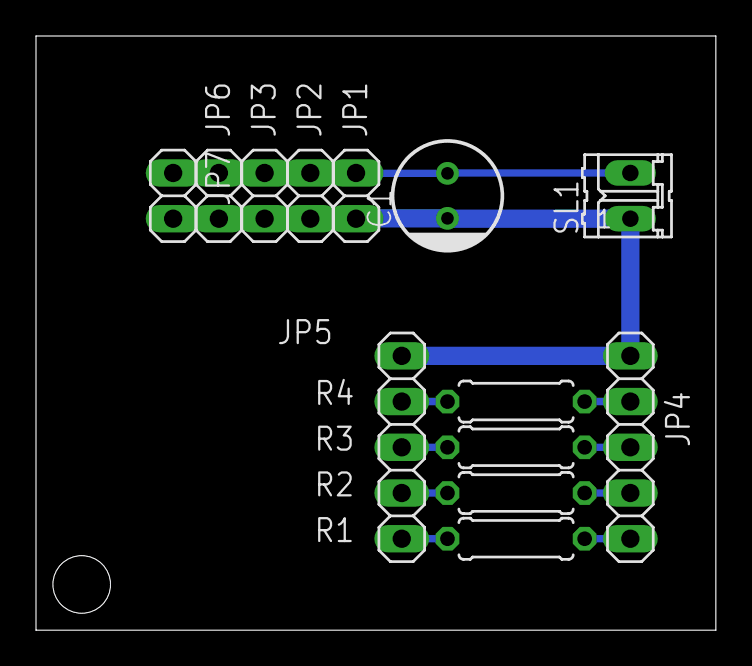
[picture p22: board Nucleo_DCO_EX1.brd from above]

Board: 2 copper layers, 37.8 x 33.0 mm, 13 parts (0 on the bottom side), 10 nets.
