ryood/Nucleo_DCO/Nucleo_DCO_Output_Board/eagle/Nucleo_DCO_Output/Nucleo_DCO_Output.brd

## EAGLE design Nucleo_DCO_Output_Board/eagle/Nucleo_DCO_Output/Nucleo_DCO_Output.brd (2018-10-27)

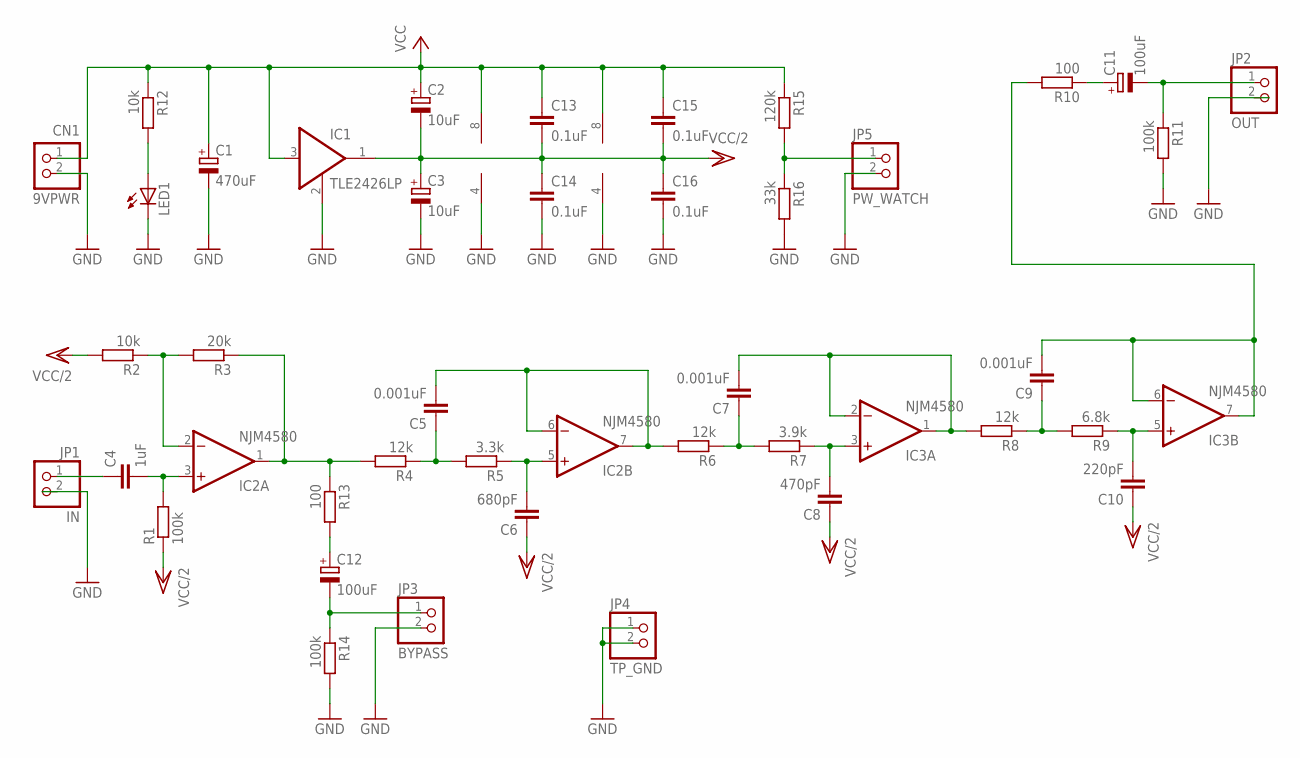
[picture p23: schematic Nucleo_DCO_Output.sch]

Parts:
C1: 470uF; SANYO-OSCON_F13
C2, C3: 10uF; E2,5-6
C4: 1uF; C050-035X075
C5, C7, C9: 0.001uF; C050-035X075
C6: 680pF; C050-035X075
C8: 470pF; C050-035X075
C10: 220pF; C050-035X075
C11, C12: 100uF; E5-8,5
C13, C15, C16: 0.1uF; C025-024X044
C14: 0.1uF; C050-024X044
CN1: 9VPWR; B2B-XH-A
IC1: TLE2426LP; TO226AA
IC2, IC3: NJM4580; DIL08
JP1: IN; 1X02
JP2: OUT; 1X02
JP3: BYPASS; 1X02
JP4: TP_GND; 1X02
JP5: PW_WATCH; 1X02
LED1: LED3MM
R1, R11, R14: 100k; 0207/7
R2, R12: 10k; 0207/7
R3: 20k; 0207/7
R4, R6, R8: 12k; 0207/7
R5: 3.3k; 0207/7
R7: 3.9k; 0207/7
R9: 6.8k; 0207/7
R10, R13: 100; 0207/7
R15: 120k; 0207/7
R16: 33k; 0207/7

Connections:
GND: C1.-, C3.-, C14.2, C16.2, CN1.2, IC1.2, IC2.4 (V-), IC3.4 (V-), JP1.2, JP2.2, JP3.2, JP4.1, JP4.2, JP5.2, LED1.K (C), R11.2, R14.2, R16.2
unnamed: IC2.1 (OUT), R3.1, R4.2, R13.1
unnamed: IC2.2 (-IN), R2.1, R3.2
unnamed: C6.2, IC2.5 (+IN), R5.1
unnamed: C4.1, JP1.1
unnamed: C4.2, IC2.3 (+IN), R1.2
unnamed: C5.1, R4.1, R5.2
unnamed: C11.+, R10.1
unnamed: C11.-, JP2.1, R11.1
unnamed: C5.2, IC2.6 (-IN), IC2.7 (OUT), R6.2
unnamed: C8.2, IC3.3 (+IN), R7.1
unnamed: C7.1, R6.1, R7.2
unnamed: LED1.A, R12.2
unnamed: C7.2, IC3.1 (OUT), IC3.2 (-IN), R8.2
unnamed: C10.2, IC3.5 (+IN), R9.1
unnamed: C9.1, R8.1, R9.2
unnamed: C9.2, IC3.6 (-IN), IC3.7 (OUT), R10.2
unnamed: C12.+, R13.2
unnamed: C12.-, JP3.1, R14.1
unnamed: JP5.1, R15.2, R16.1
VCC: C1.+, C2.+, C13.1, C15.1, CN1.1, IC1.3 (I), IC2.8 (V+), IC3.8 (V+), R12.1, R15.1
VCC/2: C2.-, C3.+, C6.1, C8.1, C10.1, C13.2, C14.1, C15.2, C16.1, IC1.1 (O), R1.1, R2.2

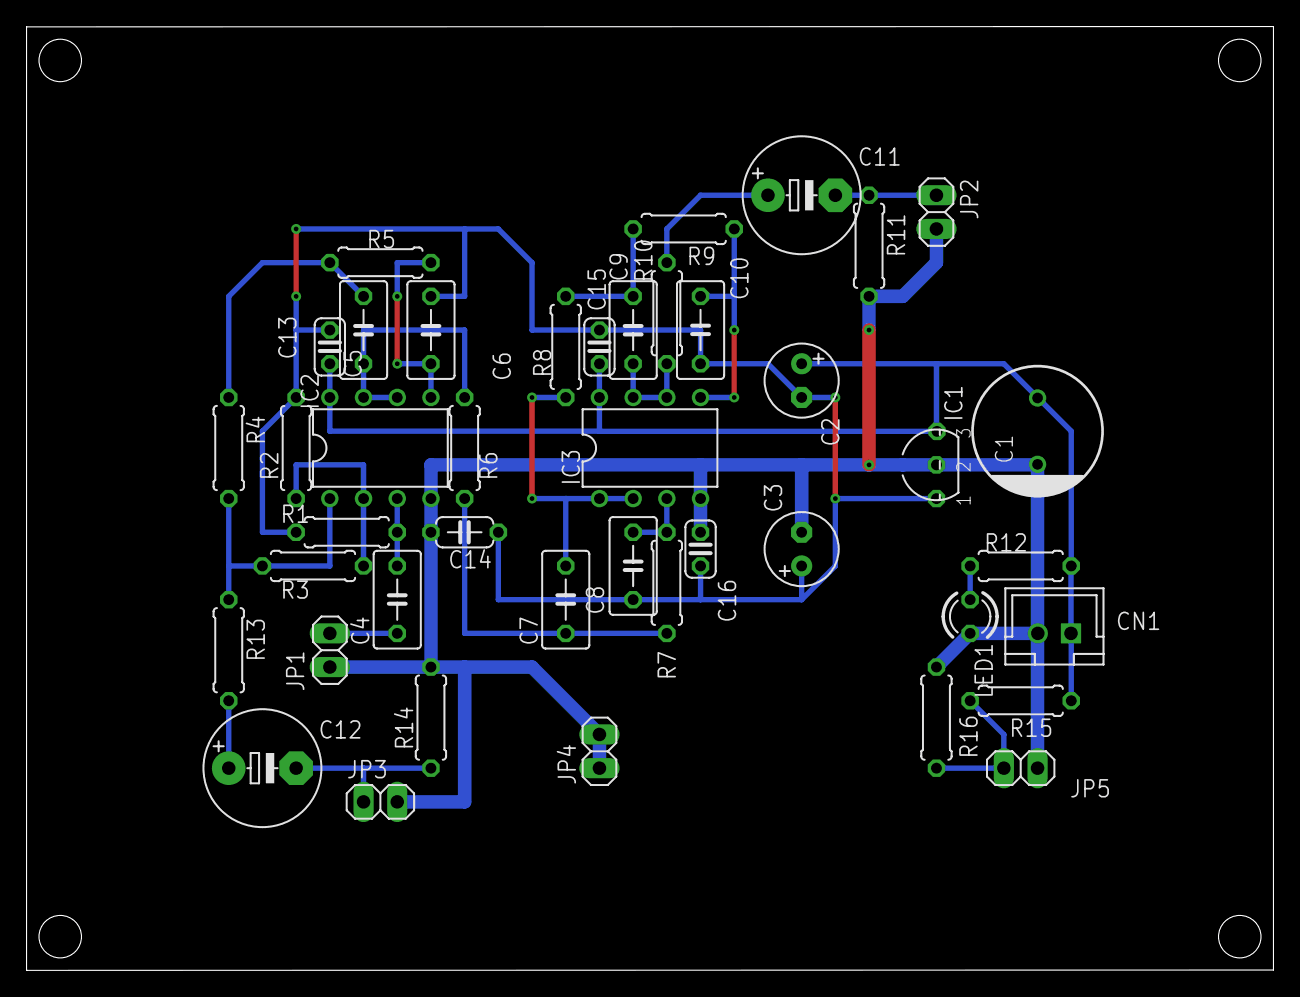
[picture p24: board Nucleo_DCO_Output.brd from above]

Board: 2 copper layers, 94.0 x 71.1 mm, 42 parts (0 on the bottom side), 22 nets.
