ryood/Nucleo_DCO/Nucleo_DCO_Output_Board/eagle/Nucleo_DCO_PSU/Nucleo_DCO_PSU.brd

## EAGLE design Nucleo_DCO_Output_Board/eagle/Nucleo_DCO_PSU/Nucleo_DCO_PSU.brd (2018-10-22)

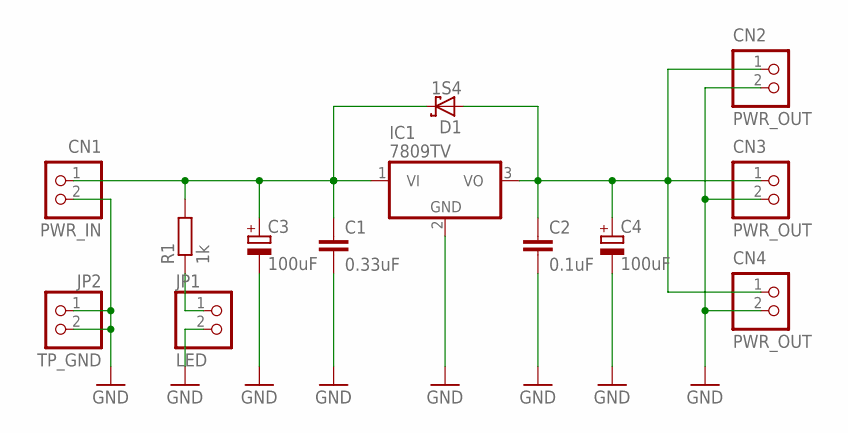
[picture p25: schematic Nucleo_DCO_PSU.sch]

Parts:
C1: 0.33uF; C025-024X044
C2: 0.1uF; C025-024X044
C3, C4: 100uF; E5-8,5
CN1: PWR_IN; B2B-XH-A
CN2, CN3, CN4: PWR_OUT; B2B-XH-A
D1: 1S4; DO35-7
IC1: 7809TV; TO220V
JP1: LED; 1X02
JP2: TP_GND; 1X02
R1: 1k; 0207/7

Connections:
GND: C1.2, C2.2, C3.-, C4.-, CN1.2, CN2.2, CN3.2, CN4.2, IC1.2 (GND), JP1.2, JP2.1, JP2.2
unnamed: JP1.1, R1.1
unnamed: C1.1, C3.+, CN1.1, D1.C, IC1.1 (VI), R1.2
unnamed: C2.1, C4.+, CN2.1, CN3.1, CN4.1, D1.A, IC1.3 (VO)

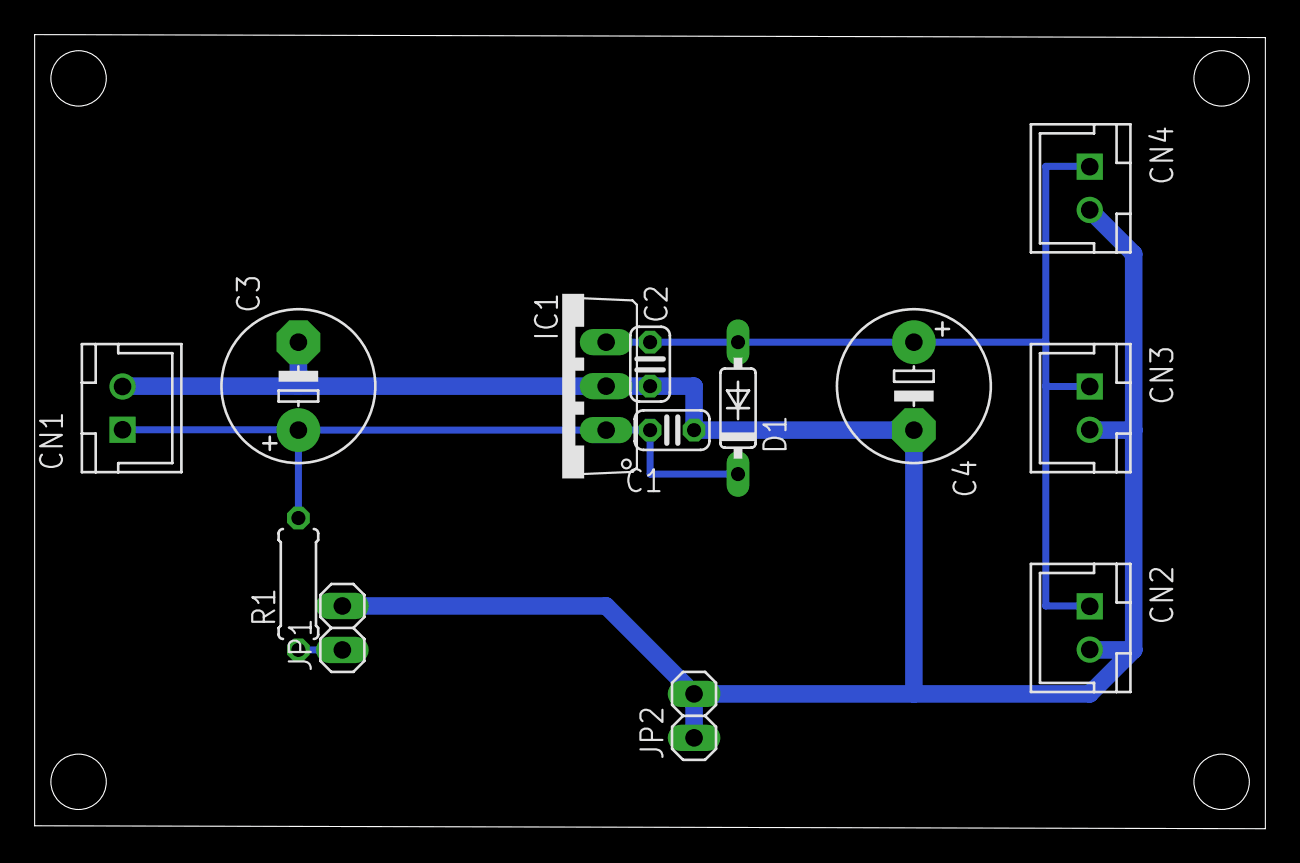
[picture p26: board Nucleo_DCO_PSU.brd from above]

Board: 2 copper layers, 71.1 x 45.9 mm, 13 parts (0 on the bottom side), 4 nets.
