ryood/Nucleo_DCO/Nucleo-Arduino_I2C_Test/Arduino/Nucleo_DCO_I2C_Slave_OLED_print_FullBuffer_Test/Nucleo_DCO_I2C_Slave_OLED_print_FullBuffer_Test.ino

/*
 * Nucleo DCO I2C Slave / OLED Module Test.
 * use u8g2::print()
 * 
 * 2018.11.11
 *
 */

#include <Wire.h>
#include <U8g2lib.h>
#include "DataComFormat.h"

#define UART_TRACE  (0)  // UART_TRACEを有効化(1)にすると、メモリーオーバーのためコンパイルできません。

#define TITLE_STR1  ("I2C Slave Test")
#define TITLE_STR2  ("20181113")

#define MASTER_TITLE_STR_LEN (32)

//U8G2_SSD1306_128X32_UNIVISION_1_HW_I2C u8g2(U8G2_R0, /* reset=*/ U8X8_PIN_NONE);  // Adafruit ESP8266/32u4/ARM Boards + FeatherWing OLED
U8G2_SSD1306_128X64_NONAME_F_4W_SW_SPI u8g2(U8G2_R0, /* clock=*/ 13, /* data=*/ 11, /* cs=*/ 10, /* dc=*/ 9, /* reset=*/ 8);

const int CheckPin1 = 2;

// Const strings
const char* waveShapeName[] = {
  "SIN",
  "TRI",
  "SWU",
  "SWD",
  "SQR",
  "NOS",
  "XXX"
};

const char* frequencyRangeName[] = {
  "A-1",
  " A0",
  " A1",
  " A2",
  " A3",
  " A4",
  " A5",
  " A6",
  " A7",
  " A8"
};

char masterTitleStr1[MASTER_TITLE_STR_LEN] = "TitleStr1";
char masterTitleStr2[MASTER_TITLE_STR_LEN] = "TitleStr2";
char masterTitleStr3[MASTER_TITLE_STR_LEN] = "TitleStr3";

volatile int displayMode = DM_TITLE;

volatile struct normalData normalData;
volatile struct frequencyData frequencyData;
volatile struct amplitudeData amplitudeData;
volatile struct pulseWidthData pulseWidthData;
volatile bool displayOffMessage;

volatile bool isDirty = true;

void setup()
{
#if (UART_TRACE)  
  Serial.begin(9600);           // start serial for output
  Serial.println();
  Serial.println(TITLE_STR1);
  Serial.println(TITLE_STR2);
#endif

  pinMode(CheckPin1, OUTPUT);
  
  // OLED
  u8g2.begin();
  
  u8g2.clearBuffer();
  
  u8g2.setFont(u8g2_font_8x13_tf);
  u8g2.setCursor(0, 10);
  u8g2.print(TITLE_STR1);
  u8g2.setCursor(0, 25);
  u8g2.print(TITLE_STR2);
  
  u8g2.sendBuffer();
    
  // I2C
  Wire.begin(I2C_ARDUINO_ADDR7);         // join i2c bus with address #8
  pinMode(A4, INPUT);           // disable pullup
  pinMode(A5, INPUT);           // disable pullup
  Wire.setClock(I2C_CLOCK);
  Wire.onReceive(receiveEvent); // register event

  delay(2000);
}

//-------------------------------------------------------------------------------------------------
// OLED Display
//
void displayTitle()
{
#if (UART_TRACE)
  Serial.println("displayTitle()");
#endif

  u8g2.clearBuffer();
  
  u8g2.setFont(u8g2_font_10x20_mf);
  u8g2.setCursor(0, 16);
  u8g2.print(masterTitleStr1);
  u8g2.setCursor(0, 32);
  u8g2.print(masterTitleStr2);
  u8g2.setCursor(0, 48);
  u8g2.print(masterTitleStr3);
  
  u8g2.sendBuffer();
}

void displayNormal()
{
 #if (UART_TRACE)
  Serial.println("displayNormal()");
#endif
  
  u8g2.clearBuffer();
  u8g2.setFont(u8g2_font_10x20_mf);

  u8g2.setCursor(4, 16);
  u8g2.print(waveShapeName[normalData.waveShape[0]]);
  u8g2.print(' ');
  u8g2.print(waveShapeName[normalData.waveShape[1]]);
  u8g2.print(' ');
  u8g2.print(waveShapeName[normalData.waveShape[2]]);

  u8g2.setCursor(4, 32);
  u8g2.print(frequencyRangeName[normalData.frequencyRange[0]]);
  u8g2.print(' ');
  u8g2.print(frequencyRangeName[normalData.frequencyRange[1]]);
  u8g2.print(' ');
  u8g2.print(frequencyRangeName[normalData.frequencyRange[2]]);

  u8g2.setCursor(4, 48);
  u8g2.print("FPS:");
  u8g2.print((float)normalData.fps/10, 1);

  u8g2.setCursor(4, 64);
  u8g2.print("BAT:");
  u8g2.print((float)normalData.batteryVoltage/10, 1);
  u8g2.print("V ");
  u8g2.print(normalData.adcAvailable ? "xx" : "AD");    

  u8g2.sendBuffer();
}

void displayFrequency()
{
#if (UART_TRACE)
  Serial.println("displayFrequency()");
#endif

  u8g2.clearBuffer();
  
  u8g2.setCursor(0, 16);
  u8g2.print("F1:");
  u8g2.print((float)frequencyData.rate[0]/10, 1);
  u8g2.print(" Hz");

  u8g2.setCursor(0, 32);
  u8g2.print("F2:");
  u8g2.print((float)frequencyData.rate[1]/10, 1);
  u8g2.print(" Hz");
  
  u8g2.setCursor(0, 48);
  u8g2.print("F3:");
  u8g2.print((float)frequencyData.rate[2]/10, 1);
  u8g2.print(" Hz");

  u8g2.setCursor(0, 64);
  u8g2.print((float)frequencyData.detune[1]/1000, 3);
  u8g2.print(' ');
  u8g2.print((float)frequencyData.detune[2]/1000, 3);

  u8g2.sendBuffer();
}

void displayAmplitude()
{
#if (UART_TRACE)
  Serial.println("displayAmplitude()");
#endif

  u8g2.clearBuffer();
  
  u8g2.setFont(u8g2_font_10x20_mf);
  u8g2.setCursor(0, 16);
  u8g2.print("AMP1: ");
  u8g2.print((float)amplitudeData.amplitude[0]/1000, 3);
  u8g2.setCursor(0, 32);
  u8g2.print("AMP2: ");
  u8g2.print((float)amplitudeData.amplitude[1]/1000, 3);
  u8g2.setCursor(0, 48);
  u8g2.print("AMP3: ");
  u8g2.print((float)amplitudeData.amplitude[2]/1000, 3);
  u8g2.setCursor(0, 64);
  u8g2.print("MAMP: ");
  u8g2.print((float)amplitudeData.masterAmplitude/1000, 3);

  u8g2.sendBuffer();
}

void displayPulseWidth()
{
#if (UART_TRACE)
  Serial.println("displayPulseWidth()");
#endif

  u8g2.clearBuffer();
  
  u8g2.setFont(u8g2_font_10x20_mf);
  u8g2.setCursor(0, 16);
  u8g2.print("PW1: ");
  u8g2.print((float)pulseWidthData.pulseWidth[0]/1000, 3);
  u8g2.setCursor(0, 32);
  u8g2.print("PW2: ");
  u8g2.print((float)pulseWidthData.pulseWidth[1]/1000, 3);
  u8g2.setCursor(0, 48);
  u8g2.print("PW3: ");
  u8g2.print((float)pulseWidthData.pulseWidth[2]/1000, 3);

  u8g2.sendBuffer();
}

void displayOff()
{
#if (UART_TRACE)
  Serial.println("displayOff()");
#endif

  u8g2.clearBuffer();
  
  u8g2.setFont(u8g2_font_10x20_mf);
  u8g2.setCursor(4, 24);
  u8g2.print("DISPLAY OFF");

  u8g2.sendBuffer();
}

//-------------------------------------------------------------------------------------------------
// Main loop
//
void loop()
{
  if (isDirty) {
    isDirty = false;
   
    switch (displayMode) {
    case DM_TITLE:
      displayTitle();
      break;
    case DM_NORMAL:
      displayNormal();
      break;
    case DM_FREQUENCY:
      displayFrequency();
      break;
    case DM_AMPLITUDE:
      displayAmplitude();
      break;
    case DM_PULSE_WIDTH:
      displayPulseWidth();
      break;
    case DM_DISPLAY_OFF:
      displayOff();
      break;
    }
  }
    
#if (UART_TRACE)  
  switch (displayMode) {
  case DM_TITLE:
    Serial.println("******* Display Title *********");
    Serial.println(masterTitleStr1);
    Serial.println(masterTitleStr2);
    Serial.println(masterTitleStr3);
    Serial.println("*******************************");
    break;
  case DM_NORMAL:
    Serial.println("*********** Normal ************");
    Serial.print("WaveShpe1: ");   Serial.println(normalData.waveShape[0]);
    Serial.print("WaveShpe2: ");   Serial.println(normalData.waveShape[1]);
    Serial.print("WaveShpe3: ");   Serial.println(normalData.waveShape[2]);
    Serial.print("FreqRange1: ");  Serial.println(normalData.frequencyRange[0]);
    Serial.print("FreqRange2: ");  Serial.println(normalData.frequencyRange[1]);
    Serial.print("FreqRange3: ");  Serial.println(normalData.frequencyRange[2]);
    Serial.print("Fps: ");         Serial.println(normalData.fps);
    Serial.print("Fps: ");         Serial.print(normalData.fps/10); Serial.print("."); Serial.println(normalData.fps%10); 
    Serial.print("BattVoltage: "); Serial.println(normalData.batteryVoltage);
    Serial.print("BattVoltage: "); Serial.print(normalData.batteryVoltage/10); Serial.print("."); Serial.println(normalData.batteryVoltage%10);
    Serial.print("ADCAvilable: "); Serial.println(normalData.adcAvailable);
    Serial.println("*******************************");
    break;
  case DM_FREQUENCY:
    Serial.println("********** Frequency **********");
    Serial.print("Rate1: ");   Serial.println(frequencyData.rate[0]);
    Serial.print("Rate1: ");   Serial.print(frequencyData.rate[0]/10); Serial.print("."); Serial.println(frequencyData.rate[0]%10);
    Serial.print("Rate2: ");   Serial.println(frequencyData.rate[1]);
    Serial.print("Rate2: ");   Serial.print(frequencyData.rate[1]/10); Serial.print("."); Serial.println(frequencyData.rate[1]%10);
    Serial.print("Rate3: ");   Serial.println(frequencyData.rate[2]);
    Serial.print("Rate3: ");   Serial.print(frequencyData.rate[2]/10); Serial.print("."); Serial.println(frequencyData.rate[2]%10);
    Serial.print("Detune1: "); Serial.println(frequencyData.detune[0]);
    Serial.print("Detune1: "); Serial.print(frequencyData.detune[0]/1000); Serial.print("."); Serial.println(frequencyData.detune[0]%1000);
    Serial.print("Detune2: "); Serial.println(frequencyData.detune[1]);
    //Serial.print("Detune2: "); Serial.print(frequencyData.detune[1]/1000); Serial.print("."); Serial.println(frequencyData.detune[1]%1000);
    Serial.print("Detune2: "); Serial.println((float)(frequencyData.detune[1])/1000.0f, 3);
    Serial.print("Detune3: "); Serial.println(frequencyData.detune[2]);
    Serial.print("Detune3: "); Serial.print(frequencyData.detune[2]/1000); Serial.print("."); Serial.println(frequencyData.detune[2]%1000);
    Serial.println("*******************************");
    break;
  case DM_AMPLITUDE:
    Serial.println("********** Amplitude **********");
    Serial.print("Amplitude1: ");      Serial.println(amplitudeData.amplitude[0]);
    Serial.print("Amplitude1: ");      Serial.println((float)(amplitudeData.amplitude[0])/1000.0f, 3);
    Serial.print("Amplitude2: ");      Serial.println(amplitudeData.amplitude[1]);
    Serial.print("Amplitude2: ");      Serial.println((float)(amplitudeData.amplitude[1])/1000.0f, 3);
    Serial.print("Amplitude3: ");      Serial.println(amplitudeData.amplitude[2]);
    Serial.print("Amplitude3: ");      Serial.println((float)(amplitudeData.amplitude[2])/1000.0f, 3);
    Serial.print("MasterAmplitude: "); Serial.println(amplitudeData.masterAmplitude);
    Serial.print("MasterAmplitude: "); Serial.println((float)(amplitudeData.masterAmplitude)/1000.0f, 3);
    Serial.print("Clip: ");            Serial.println(amplitudeData.clip); 
    Serial.println("*******************************");
    break;
  case DM_PULSE_WIDTH:
    Serial.println("********* Pulse Width *********");
    Serial.print("PulseWidth1: ");     Serial.println(pulseWidthData.pulseWidth[0]);
    Serial.print("PulseWidth1: ");     Serial.println((float)(pulseWidthData.pulseWidth[0])/1000.0f, 3);
    Serial.print("PulseWidth2: ");     Serial.println(pulseWidthData.pulseWidth[1]);
    Serial.print("PulseWidth2: ");     Serial.println((float)(pulseWidthData.pulseWidth[1])/1000.0f, 3);
    Serial.print("PulseWidth3: ");     Serial.println(pulseWidthData.pulseWidth[2]);
    Serial.print("PulseWidth3: ");     Serial.println((float)(pulseWidthData.pulseWidth[2])/1000.0f, 3);
    Serial.println("*******************************");
    break;
  case DM_DISPLAY_OFF:
    Serial.println("********* Display Off *********");
    Serial.print("DisplayOffMessage: "); Serial.println(displayOffMessage);
    Serial.println("*******************************");
  }
  delay(1000);
#endif
}

//-------------------------------------------------------------------------------------------------
// I2C Event
//
void receiveEvent(int byteN)
{
#if (UART_TRACE)  
  Serial.println("receiveEvent()");
#endif
  
  displayMode = Wire.read();

#if (UART_TRACE)  
  Serial.print("displayMode: ");
  Serial.println(displayMode);
#endif

  digitalWrite(CheckPin1, HIGH);

  uint8_t* p;
  switch (displayMode) {
  case DM_TITLE:
    break;
  case DM_TITLE_STR1:
    for (int i = 0; i < MASTER_TITLE_STR_LEN; i++) {
      masterTitleStr1[i] = Wire.read();
    }
    break;
  case DM_TITLE_STR2:
    for (int i = 0; i < MASTER_TITLE_STR_LEN; i++) {
      masterTitleStr2[i] = Wire.read();
    }
    break;
  case DM_TITLE_STR3:
    for (int i = 0; i < MASTER_TITLE_STR_LEN; i++) {
      masterTitleStr3[i] = Wire.read();
    }
    break;
  case DM_NORMAL:
    p = (uint8_t *)&normalData;
    for (int i = 0; i < sizeof(struct normalData); i++) {
      p[i] = Wire.read();
    }
  case DM_FREQUENCY:
    p = (uint8_t *)&frequencyData;
    for (int i = 0; i < sizeof(struct frequencyData); i++) {
      p[i] = Wire.read();
    }
    break;
  case DM_AMPLITUDE:
    p = (uint8_t *)&amplitudeData;
    for (int i = 0; i < sizeof(struct amplitudeData); i++) {
      p[i] = Wire.read();
    }
    break;
  case DM_PULSE_WIDTH:
    p = (uint8_t *)&pulseWidthData;
    for (int i = 0; i < sizeof(struct pulseWidthData); i++) {
      p[i] = Wire.read();
    }
    break;
  case DM_DISPLAY_OFF:
    displayOffMessage = Wire.read();
    break;
  }

  isDirty = true;
  
  digitalWrite(CheckPin1, LOW);
}
