ryood/Nucleo_DCO/mbed/Nucleo_DCO_Test24/RotaryEncoder/RotaryEncoder.cpp

/**
 * =============================================================================
 * Rotary Encoder class (Version 0.0.1)
 * =============================================================================
 * Copyright (c) 2010 Shinichiro Nakamura (CuBeatSystems)
 *
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
 * THE SOFTWARE IS PROVIDED "AS IS", WITHOUT WARRANTY OF ANY KIND, EXPRESS OR
 * IMPLIED, INCLUDING BUT NOT LIMITED TO THE WARRANTIES OF MERCHANTABILITY,
 * FITNESS FOR A PARTICULAR PURPOSE AND NONINFRINGEMENT. IN NO EVENT SHALL THE
 * AUTHORS OR COPYRIGHT HOLDERS BE LIABLE FOR ANY CLAIM, DAMAGES OR OTHER
 * LIABILITY, WHETHER IN AN ACTION OF CONTRACT, TORT OR OTHERWISE, ARISING FROM,
 * OUT OF OR IN CONNECTION WITH THE SOFTWARE OR THE USE OR OTHER DEALINGS IN
 * THE SOFTWARE.
 * =============================================================================
 */

#include "RotaryEncoder.h"

/**
 * Create rotary encoder.
 *
 * @param pin1_name
 * @param pin2_name
 * @param min Minimum value.
 * @param max Maximum value.
 * @param val Default value.
 */
RotaryEncoder::RotaryEncoder(PinName pin1_name, PinName pin2_name, int min, int max, int val)
        : pin1(pin1_name), pin2(pin2_name), min(min), max(max), val(val) {
    pin1.mode(PullUp);
    pin2.mode(PullUp);
    ticker.attach_us(callback(this, &RotaryEncoder::func_ticker), 500);
}

/**
 * Dispose.
 */
RotaryEncoder::~RotaryEncoder() {
}

/**
 * Internal tick function.
 */
void RotaryEncoder::func_ticker() {
    //static uint8_t code;

    code = (code << 2) + (((pin1.read() << 1) | (pin2.read() << 0)) & 3);
    code &= 15;
    switch (code) {
        case 0x7:
            if (min < val) {
                val--;
            } else {
                val = min;
            }
            break;
        case 0xd:
            if (val < max) {
                val++;
            } else {
                val = max;
            }
            break;
    }
}
