ryood/Nucleo_DCO/mbed/Nucleo_DCO_Test03/wavetable_12bit_32k.h

/*
 * wavetable_12bit_32k.h
 * 
 * 2018.07.24
 * 
 */
 
#ifndef _WAVETABLE_12bit_32k_H_
#define _WAVETABLE_12bit_32k_H_

/*** MAX_VALUE = 4096 SAMPLE_NUM = 32768 delta = 0.124969***/
/*** sine wave ***/
const uint16_t sin_12bit_32k[] = {
    2047    ,
    2047    ,
    2048    ,
    2048    ,
    2049    ,
    2049    ,
    2049    ,
    2050    ,
    2050    ,
    2051    ,
    2051    ,
    2051    ,
    2052    ,
    2052    ,
    2052    ,
    2053    ,
    2053    ,
    2054    ,
    2054    ,
    2054    ,
    2055    ,
    2055    ,
    2056    ,
    2056    ,
    2056    ,
    2057    ,
    2057    ,
    2058    ,
    2058    ,
    2058    ,
    2059    ,
    2059    ,
    2060    ,
    2060    ,
    2060    ,
    2061    ,
    2061    ,
    2062    ,
    2062    ,
    2062    ,
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
};

#endif // _WAVETABLE_12bit_32k_H_
