ryood/Nucleo_DCO/(commit log)

2018-08-19 first commit; Test01
    [Nucleo_DCO_ブロック図.xlsx]
2018-09-01 Nucleo_DCO_Test05: Update phase moduration
    [Nucleo_DCO_Test04 ピンアサイン.xlsx]
2018-09-08 Add: InterruptIn_Test01
2018-09-08 Add: InterruptIn_Test03 (Multi InterruptIn, F767ZI)
2018-09-08 Nucleo_DCO接続一覧表.xlsx
    [Nucleo_DCO接続一覧表.xlsx]
2018-09-08 Update: InterruptIn_Test03
    [Nucleo_DCO接続一覧表.xlsx]
2018-09-08 Add: Nucleo_DCO_Test09 (InterruptIn)
2018-09-08 InterruptIn_Test03: use attach_us()
    [Nucleo_DCO接続一覧表.xlsx]
2018-09-10 Update: Nucleo_DCO_ブロック図
    [Nucleo_DCO_ブロック図.xlsx]
2018-09-11 Add: Pot_Panel_Test01, Pot_Test02
    [NucleoDCO_POT_Panel(Test).dwg, Nucleo_DCO_ブロック図.xlsx]
2018-09-13 Update: Nucleo_DCO接続一覧表
    [Nucleo_DCO接続一覧表.xlsx]
2018-09-13 Update: Nucleo_DCO ブロック図.png
2018-09-13 InterpolateFloat_Test01: multi ADC
2018-09-14 Add: doc (Documents)
    [Nucleo_DCO_Detune_Curve.xlsx, Nucleo_DCO_Panel_Design.xlsx, Nucleo_DCO_pruning.xlsx]
2018-09-14 Add: Nucleo_DCO_Test14 (Interpolate ADC)
2018-09-15 Add: RotaryEncoder_Test01
    [Nucleo_DCO接続一覧表.xlsx]
2018-09-15 Nucleo_DCO_Test16: ADC 10bit precision
2018-09-17 Update: Pannel Design
    [Nucleo_DCO_Panel_Design.xlsx]
2018-09-17 Update: Nucleo_DCO ブロック図
    [Nucleo_DCO_ブロック図.xlsx]
2018-09-20 Add: ADC_VREF_TEST01
    [ADC_VREF_Test01.fzz]
2018-09-20 Update: Panel Design
    [NucleoDCO_RotEnc_Panel(Test).dwg, Nucleo_DCO_Panel_Design.xlsx]
2018-09-20 Nucleo_DCO_Test17: Impl PulseWidth Led, Clip Led
2018-09-20 Nucleo_DCO_Test17: UART Trace FPS
2018-09-22 Add Nucleo_DCO_Test18
    [Nucleo_DCO_ブロック図.xlsx]
2018-09-23 InterruptIn_Test03: Use the panel push switches
2018-09-23 Nucleo_DCO_Test18: Panel switches
    [Nucleo_DCO_ブロック図.xlsx, Nucleo_DCO接続一覧表.xlsx, Nucleo_DCO接続一覧表_20180923.xlsx]
2018-09-25 Add Nucleo_DCO_Test19 (ADC Off)
    [Nucleo_DCO_Panel_Design.xlsx, Nucleo_DCO_ブロック図.xlsx, Nucleo_DCO接続一覧表.xlsx]
2018-10-01 Nucleo_DCO_Test19: bug fix (pulse width display )
    [main.cpp]
2018-10-01 Nucleo_DCO_Test20: Impl. Thread
2018-10-01 Add: Nucleo_DCO_Test21 (ADC Thread only)
2018-10-03 Test19, Test20, Test21: Serial print ProjectName, time
2018-10-06 Add Nucleo_DCO_Test20_Single_Supply_OutputBoard.fzz
    [Nucleo_DCO_Test20_Single_Supply_OutputBoard.fzz]
2018-10-10 Add: Nucleo_DCO_LPF
    [Nucleo DCO LPF 設計.xlsx, Nucleo_DCO_Output_VCVS_6th_Bessel _VGND.fzz, Nucleo_DCO_Output_VCVS_6th_Bessel.fzz, Nucleo_DCO_出力部_ブロック図.xlsx]
2018-10-19 Add eagle files
    [GateGen01.fzz, Nucleo_DCO_Output.brd, Nucleo_DCO_Output.sch, Nucleo_DCO_PSU.fzz, Nucleo_DCO_PSU.sch, Nucleo_DCO_出力部_ブロック図.xlsx]
2018-10-22 Update: Nucleo_DCO_Output (add de-coupling cap)
    [Nucleo_DCO_Output.brd, Nucleo_DCO_Output.sch]
2018-10-27 Nucleo_DCO_Output_Board: Soldering
    [Nucleo DCO Output Board テスト表.xlsx, Nucleo DCO Output Board 周波数特性.xlsx, Nucleo_DCO_Output.brd, Nucleo_DCO_ブロック図.xlsx, Nucleo_DCO_出力部_ブロック図.xlsx]
2018-11-09 Add: I2C_Master_OLED_Test01
    [Nucleo DCO接続対応表.xlsx, Nucleo_DCO_ブロック図.xlsx, Nucleo_DCO接続一覧表.xlsx, Nucleo_DCO表示データ・I2C通信・フォーマット.xlsx]
2018-11-09 I2C_Master_OLED_Test01: send string ok.
2018-11-09 I2C_Master_OLED_Test01: send TITLE_STR2 ok.
2018-11-09 I2C_Master_OLED_Test01: send TITLE_STR3 NG.
2018-11-09 I2C_Master_OLED_Test01: 文字列の送出を分離
    [Nucleo_DCO表示データ・I2C通信・フォーマット.xlsx]
2018-11-09 I2C_Master_OLED_Test01: 文字列の送出を分離（タイミング調整 wait_ms(1)）
2018-11-11 Make directory: Nucleo-Arduino_I2C_Test
2018-11-11 Nucleo-Arduino_I2C_Test: UserButton
2018-11-11 Add: Nucleo_DCO_I2C_Slave_OLED_print_Test (user u8g2::print())
2018-11-12 Nucleo-Arduino_I2C_Test: u8g2 FullBuffer
2018-11-17 Update: chassis design
    [NucleoDCO_POT_Panel(Test).dwg, NucleoDCO_RotEnc_Panel(Test).dwg, Nucleo_DCO_Bottom_Panel.dwg, Nucleo_DCO_Top_Panel.dwg]
2018-11-17 Update: Top Panel Design (180mm Width)
    [Nucleo_DCO_Top_Panel.dwg]
2018-11-21 Update: Nucleo_DCO_Panel_Design
    [Nucleo_DCO_Panel_Design.xlsx]
2018-11-24 Add: Nucleo_DCO_Test23
    [Nucleo DCO接続対応表.xlsx, Nucleo_DCO_Panel_Design.xlsx, Nucleo_DCO接続一覧表.xlsx]
2018-11-24 Add: RotaryEncoder_Test03
    [Nucleo_DCO_Panel_Design.xlsx, Nucleo_DCO_ブロック図.xlsx, Nucleo_DCO接続一覧表_20180923.xlsx]
2018-11-26 Add: Nucleo_DCO_EX1 board design
    [Nucleo_DCO_EX1.brd, Nucleo_DCO_EX1.sch]
2018-11-26 Nucleo_DCO_Test23: Exchange Leds Pin asign
2018-12-01 Add: Nucleo_DCO 出音テスト
    [Arduino EG テスト ブロック図.xlsx, Nucleo_DCO + Dual_OTA_VCA ＋Arduino_EG テストブロック図.xlsx, Nucleo_DCO + TLF 01(AntiLogMM) +Dual_OTA_VCA ＋Arduino_EG テストブロック図.xlsx, Nucleo_DCO + TLF 01(AntiLogMM) +Dual_OTA_VCA＋Arduino_EG テストブロック図_V2.xlsx]
2018-12-01 Update: Panel_Design
    [Nucleo DCO接続対応表.xlsx, Nucleo_DCO_Panel_Design.xlsx]
